ChenFU-CN13/esp32-stm32-ab-ota/DOC/images/hardware/项目实物图2.jpg

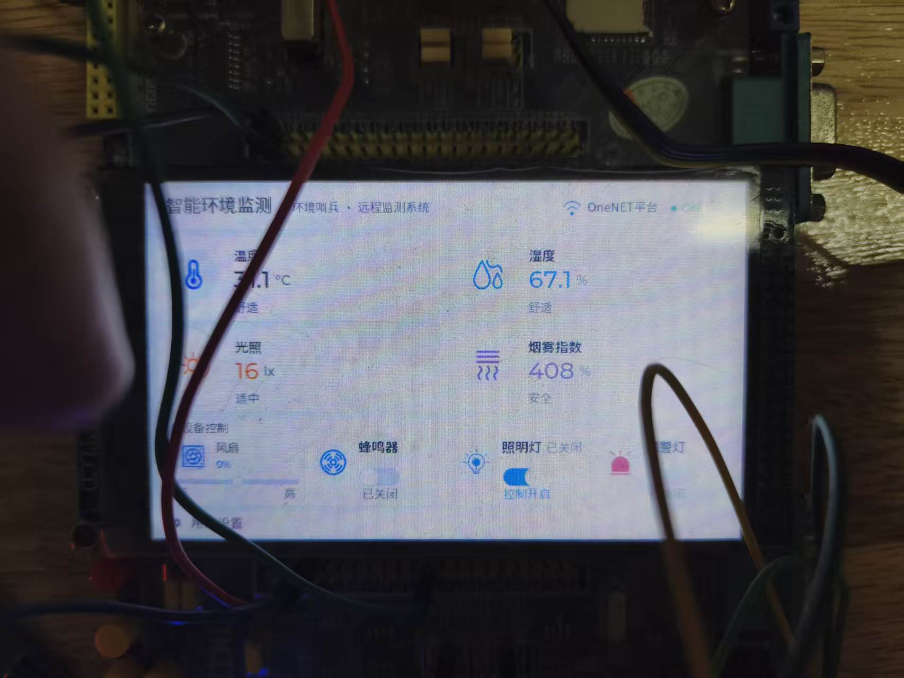
DOC/images/hardware/项目实物图2.jpg
