ChenFU-CN13/esp32-stm32-ab-ota/DOC/images/hardware/BH1750反面.png

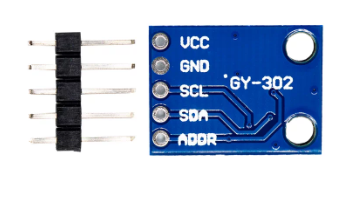
DOC/images/hardware/BH1750反面.png
