ChenFU-CN13/esp32-stm32-ab-ota/ESP32S3-OTA/readme.txt

注意:每次复制上一个项目进行修改时，cmake不会自动更改相对应的绝对路径，所以
每次都需要先在端口中输入idf.py fullclean 清理缓存，然后重新buil一下，这样文件才不会爆红

本次test10
加入了串口固件传输协议
/*============================================================================
 *                      串口固件传输协议定义
 *============================================================================
 * 协议帧格式说明：
 * 
 * 1. 固件信息帧（命令0x05）：
 *    | 包头(1) | 命令(1) | 固件大小(4) | 分隔符(2) | 版本号(4) | CRC32(4) | 包尾(1) |
 *    总长度：17字节
 * 
 * 2. 固件数据帧（命令0x06）：
 *    | 包头(1) | 命令(1) | 包序号(2) | 数据长度(4) | 数据(1024) | CRC32(4) | 包尾(1) |
 *    总长度：1037字节
 * 
 * 3. 简单命令帧（通知/确认/结束）：
 *    | 包头(1) | 命令(1) | 包尾(1) |
 *    总长度：3字节
 * 
 * 传输流程：
 *    ESP32 -> STM32: 升级通知(0x01)
 *    STM32 -> ESP32: ACK应答(0x02)
 *    ESP32 -> STM32: 确认(0x03)
 *    STM32 -> ESP32: ACK应答(0x02)
 *    ESP32 -> STM32: 开始传输(0x04)      <-- ESP32主动通知开始传输
 *    STM32 -> ESP32: ACK应答(0x02)       //此时STM32应先完成檫除，再应答
 *    ESP32 -> STM32: 固件信息(0x05)
 *    STM32 -> ESP32: ACK应答(0x02)
 *    ESP32 -> STM32: 数据包0~N(0x06)
 *    STM32 -> ESP32: ACK应答(0x02) [每包都应答]
 *    ESP32 -> STM32: 升级结束(0x07)
 *    STM32 -> ESP32: ACK应答(0x02) [然后重启]
 *============================================================================*/
