ChenFU-CN13/esp32-stm32-ab-ota/STM32-OTA/readme.txt

当前初步OTA升级已经完成了

不过一些流程还是要手动实施一步分才行

流程：1.STM32端要先把B区下载，然后再把测试A区下载
然后上传APP固件到onenet平台，先下发验证升级

2.此时EPS32开始下载固件到spiffs文件系统中

3.接着STM32与ESP32保持正常串口通讯即可

后续优化：
1.ESP32要可以持续监听onenet平台下发固件版本升级通知
并且不能影响物模型数据上传到onenet平台

2.ESP32传输完成固件后，就需要最新的版本号上报给onenet平台

3.STM32更新完成后会直接跳转到A区
首先在程序开始时，要把存储在AT24C02的版本号发送给
ESP32,ESP32要接收到并上报给onenet平台

4.在A区运行时，要添加监听ESP32是否传过来固件升级通知
如果有就要及时跳转回B区，也就是重启

5.双端加入NACK机制
STM32如果接收数据帧，信息帧等 数据包出现 大小不一致，内容不一致
就返回NACK,如果ESP32就暂停发送数据包

6.STM32利用W25Q128实现3分区，在收到2次握手后，
先把当前A分区的固件，存储到W25Q128中，然后再进行协议传输
因为A区固件是一边接收一边写入，所以当出现任意一帧数据解析有问题
就返回NACK给ESP32停止发送数据包
并且进行固件版本回滚

注意：版本号，固件大小也要回滚，也要在收到2次握手后
在AT24C02中开辟新空间，把旧的的固件信息写入到里面

回滚时读取出来

7.STM32app程序开始时，要想办法，可以在LVGL上可以显示当前版本号
（点击设置按钮后，可以看到版本信息，后续改为不是收到升级通知帧就马上
重启到B区，而是自主选择重启时机，因此ESP32那边也要想办法适配）
