ChenFU-CN13/esp32-stm32-ab-ota/DOC/development-notes/STM32_A区APP开发与实机验证记录.md

# STM32 A区 APP 开发与实机验证记录

> 本文件只记录 STM32 A区业务 APP 的开发完成度、实机验证、遗留问题和下一步建议；整个双端工程与 OTA 总进度以根目录 `README.md` 为准。

记录日期：2026-10-17
当前阶段：S1~S5与SHT30 Modbus替换已进入正式业务链，正式版v2.0.0 OTA回归通过；进入发布材料与Git稳定基线整理
正式目标：STM32-OTA/A区智能哨兵环境监测系统
APP 版本：v2.0.0

一、本轮已完成
--------------

1. STM32 驱动层
   - 新增 fan_pwm.c/h：PE5/TIM9_CH1、PE6/TIM9_CH2，两路同步 PWM，默认 0%。
   - 当前计数频率 10 kHz、周期计数 100，因此实际 PWM 频率为 100 Hz；80% 占空比已实机带动当前 5V 两线风扇。
   - 新增 mq2.c/h：PA1/ADC1_IN1，12 位 ADC；任务每 500 ms 采集一次，每次取 5 点中位数。
   - 新增 bh1750.c/h：PB6(SCL)/PB7(SDA) 软件 I2C，ADDR 接地地址 0x23，连续高分辨率模式；按 raw×5/6 换算 lux。
   - 新增 modbus_th.c/h：USART3（PB10/PB11）连接外接自动方向TTL-RS485模块，按Modbus RTU读取SHT30定点温湿度。
   - USART3使用9600、8N1，从机地址1；不使用板载RS485电路，不配置DE/RE引脚。
   - PB10/PB11不再给BH1750使用，已经作为正式SHT30采集链路启用。

2. 配置管理
   - 新增 config_manager.c/h，app_config_t 固定 16 字节，地址 0x70~0x7F。
   - 当前默认值：温度 28.0℃、湿度 80%、烟雾 ADC 1500、光照 5/20 lx。
   - 已加入一次性兼容迁移：EEPROM 中若仍是旧光照默认值 50/200 lx，则迁移为 5/20 lx，其他用户配置保持不变。
   - 加减按钮只更新 RAM；点击“保存设置”后统一写 EEPROM，再读回比对；magic 无效时恢复默认值并保存。

3. 报警与执行器仲裁
   - 新增 alarm_engine.c/h、fan_controller.c/h；AlarmEngineTask 每 200 ms 运行一次，连续 10 次成立或解除后才切换，约 2 秒去抖。
   - 所有阈值均采用严格大于号：当前值等于阈值时不报警，超过阈值约 2 秒才报警。
   - 烟雾为最高优先级：红灯快闪、蜂鸣器断续响、双风扇 100%。
   - 温度或湿度任一超限：双风扇固定 80%，不强制声光报警；当前仍是分段控制，不是 PI/PID。
   - 风扇 PWM 只有 AlarmEngineTask 一个最终写入点，LVGL 风扇条只显示最终占空比。
   - 自动照明控制默认开启。LVGL 开关表示“自动控制是否允许”，另行显示照明灯当前实际状态，避免把“自动控制开启”误解为“灯已点亮”。

4. FreeRTOS 与 LVGL UI
   - 已接入 SHT30Task、SmokeTask、LightTask、AlarmEngineTask；旧DHT11Task已退出正式业务链。
   - 首页周期显示温度、湿度、烟雾 ADC、光照 lux、风扇占空比和 IOT ON/NC 状态，并加入 USART1 数据日志。
   - STM32内部温湿度使用`temp_x10/humi_x10`定点数，LVGL显示1位小数；数据无效时显示`NC`。
   - 设置页已接入温度、湿度、光照上限和烟雾阈值；“保存设置”“恢复默认”已接入配置管理。
   - 正式版本为v2.0.0；升级后AT24C02版本字段、STM32上报和ESP32确认结果一致。

5. STM32 与 ESP32-S3
   - STM32 新增 0x06 烟雾、0x07 光照、0x08 双风扇最终占空比上报。
   - ESP32-S3 已增加对应帧的校验、队列解析和 OneNET 属性上报。
   - 新增 0x0A 心跳：ESP32 每 5 秒发送 OneNET 在线状态；STM32 超过 15 秒未收到则显示 NC；心跳不回 ACK。
   - OneNET 当前使用 Alarm、Fan、LED、Lux、Smoke、hum、temp 共 7 个属性；IOT 心跳只用于本地显示。
   - 温湿度0x01/0x02业务帧格式保持不变；STM32发送前将x10定点数四舍五入成整数，因此ESP32和OneNET本轮不需要修改。

二、已完成的静态检查
--------------------

1. Keil uvprojx XML 可解析，新增驱动、服务、HAL ADC和modbus_th.c文件已注册。
2. 已检查 0x06/0x07/0x08/0x0A 协议、OneNET 属性大小写、配置单次写入、风扇单点输出和照明状态显示路径。
3. 正式APP已取消NO_BOOT_MODE，链接地址恢复为`0x08010000`；Bootloader链接范围限制为64KB，ESP32 OTA Manager已重新启用。
4. 本次文档同步没有由Codex重新运行Keil或ESP-IDF编译；下面的硬件结果来自BOSS已完成的编译、烧录、串口日志、截图和仪器测量。

三、已完成的实机验证
--------------------

1. 共地问题已解决
   - 初次接线时 STM32、外部电源、传感器和风扇驱动没有统一信号地，出现 BH1750 初始化成功但长期读 0 等现象。
   - 正确接法：STM32 GND、外部电源 GND、各传感器 GND、风扇驱动 GND 必须共地；模块 VCC 可由外部电源供电。
   - 不要直接并联两个不同来源的 VCC 电源轨，共地只用于建立统一信号参考。

2. 光照链路
   - BH1750 初始化成功；遮住感光窗口后读数可接近 0，说明当前基本 I2C 通讯和感光响应正常。
   - 房间实测“开灯约 32 lx、关灯约 0~3 lx”，因此光照默认滞回从 50/200 lx 调整为 5/20 lx。
   - 自动照明默认开启及“控制状态/实际灯状态”分离已完成。

3. 温湿度阈值与风扇报警链路
   - 湿度阈值设为 60% 时，读数等于 60% 不触发；读数为 61% 并持续约 2 秒后打印 `[ALARM] level 0 -> 1, fan=80%`。
   - 湿度回到 60% 并持续约 2 秒后打印 `[ALARM] level 1 -> 0, fan=0%`。
   - 该结果确认严格 `>` 比较、2 秒去抖、报警等级切换和 0/80% PWM 命令链路均已运行。

4. 风扇 PWM 硬件链路
   - PE5 栅极测得约 80% 占空比，栅极与 MCU 输出一致；低边 MOS 漏极波形呈互补关系，说明 TIM9、GPIO 复用和 MOS 开关路径正常。
   - 风扇 IN 直接接 3.3V 时可以全速启动，说明风扇、电源和驱动板主回路可工作。
   - 原 10 kHz PWM 下只有电流声、风扇不转；改为 100 Hz 后，80% 占空比可以正常起转。该结论仅针对当前这款两线 5V 风扇和驱动板，不外推到所有风扇。

5. MQ-2 预热
   - 上电早期 ADC 长时间保持 4095，约 15 分 46 秒后降到约 370 并逐渐稳定，证明必须设置预热屏蔽期。
   - 当前源码预热时间为 1200000 ms（20 分钟）；预热期间允许采样和显示，但烟雾数据不参与报警。

6. SHT30 Modbus温湿度链路
   - F103来源驱动的16位定点读取和32位浮点读取此前已经完成编译、烧录和逻辑分析仪验证。
   - F407冒烟阶段可见请求`01 04 00 00 00 02 71 CB`及合法响应；示例响应解析为30.8℃、64.6%RH，CRC正确。
   - BOSS于2026-10-17确认正式业务代码能够正常通讯，LVGL能够正常显示1位小数。
   - 本次只把正常通讯和正常显示标记为实机通过；ESP32/OneNET整数上报及RS485故障退化仍需最终回归。

7. 正式版v2.0.0 OTA回归
   - BOSS于2026-10-17完成正式双端OTA升级回归。
   - 新APP启动后从AT24C02读取`2.0.0`并上报；ESP32日志确认`STM32 APP version=2.0.0`，Manager进入`REPORT_RESULT`。
   - 现场截图确认STM32侧收到ESP32版本ACK，并打印“ESP32已确认当前APP版本 2.0.0”。本记录不补写截图未提供的包数和CRC32。

四、踩过的坑与当前遗留问题
--------------------------

1. 风扇 PWM 频率不能只按通用经验决定
   - 现象：10 kHz、80% 时只听到嘶嘶声，风扇不转。
   - 排查：PE5、MOS 栅极、漏极波形正常，IN 直给 3.3V 能全速转。
   - 结论：当前两线无刷风扇内部驱动与 10 kHz 斩波不匹配，100 Hz 实机可用。以后更换风扇后要重新测启动占空比和适用频率。

2. 风扇动作会干扰 MQ-2 ADC，尚未修复
   - 现象：风扇 100 Hz、80% 工作时，MQ-2 偶发从约 280~550 突跳到 4095；调高温湿度阈值让风扇停止后，4095 突跳消失。
   - 当前判断：这条因果关系已经由对照实验确认；具体耦合路径仍未确认，优先怀疑电源压降、地弹噪声、MOS 开关干扰或 ADC 输入瞬时过压。
   - 当前 5 点中位数是一次连续快速采样，如果干扰持续覆盖这 5 点，仍会得到 4095，不能替代硬件排查。
   - 后续检查：分别测 5V、3.3V、VDDA、PA1/AO 和地线压差；风扇电源支路加近端电容并优化星形接地；必要时给 AO 加 RC 滤波和限压/分压。
   - 风扇模块若由 5V 供电，MQ-2 AO 是否可能超过 STM32 ADC 允许范围尚未完成实测和数据手册核对，不能直接下结论。

3. BH1750 基本通讯正常，但长期数值变化原因未定
   - 遮住窗口可接近 0，说明不能再简单归因于“I2C 不通”。
   - 房间灯光不变时，数值曾从约 33 lx 上升到 166~177 lx；还需做“风扇停/转”对照、固定传感器位置、排除屏幕和环境反射，并测模块供电与地线噪声。

4. DHT11间歇失败已通过替换采集源退出当前业务链
   - 原DHT11的`read FAIL/recovered`证据继续保留，说明更换工业通信传感器的原因。
   - 正式温湿度来源已经改为USART3外接SHT30 Modbus模块；DHT11驱动源文件暂时保留作回退材料，但任务和业务有效标志已经移除。

5. MQ-2 日志文字与实际预热常量不一致
   - 当前实际常量为 20 分钟，但启动日志仍可能打印 180 s，源码注释也曾写成约 16 分钟。
   - 本轮按“先记录、不处理小 BUG”的决定保留，后续修复时只同步文字，不改变已经验证的预热策略。

五、下一步控制升级：先做 PI，不直接上完整 PID
------------------------------------------

1. 控制对象定义
   - 当前两线风扇没有转速反馈，无法做真正的风扇转速闭环。
   - 下一步 PI 控制的是“温度/湿度偏差 → 风扇 PWM 占空比”，属于环境量慢闭环；烟雾报警仍保留 100% 最高优先级覆盖。

2. 传感器升级状态
   - PB10/PB11对应USART3的SHT30 Modbus采集已经完成正式接入，STM32内部和LVGL保留0.1精度。
   - 当前驱动已有CRC和超时返回，失败时UI显示`NC`，报警引擎不再使用旧温湿度；自动重试采用下一个1秒采集周期重新读取。
   - 完成断电、A/B接反、ESP32/OneNET上报和恢复回归后，再接PI，避免控制算法建立在未经故障验证的输入上。

3. PI 第一版建议
   - PWM 载波继续使用已验证的 100 Hz；PI 计算周期按温湿度传感器速度设置为 2~5 秒，不需要跟着 PWM 周期计算。
   - 温度误差和湿度误差分别计算需求占空比，最终取较大值；输出限幅 0~100%。
   - 加入最小可运行占空比、启动时短暂 100% 助推、积分限幅/抗饱和，防止低占空比只响不转和积分越积越大。
   - 传感器无效或 RS485 超时进入安全退化；烟雾报警直接强制 100%，不经过 PI。
   - 调参顺序：先令 Ki=0 调 Kp，再逐步增加 Ki 消除稳态误差；当前阶段不加 D，避免放大现场通讯和环境噪声。

六、暂缓项
----------

1. 仍需修复：风扇引起的 MQ-2 4095、BH1750 长期漂移和 MQ-2 预热日志文字不一致。DHT11间歇失败已通过SHT30替换退出正式业务链。
2. 暂不实现：PI、手动风扇输入、OneNET 0x8X 阈值下发、报警复位/冷却、历史记录、ESP32 自升级。
3. AT24C02 `0x2C`版本字段已随正式OTA更新为v2.0.0，并完成STM32读取、ESP32确认闭环。
4. 正式发布配置不再使用NO_BOOT_MODE；如以后临时恢复直刷调试，必须重新检查链接地址和版本元数据边界。

七、最终项目打磨顺序
--------------------

1. 先完成Keil全量编译和基础回归：SHT30小数显示、温湿度80%风扇、烟雾100%覆盖、光照灯、IOT心跳和配置保存。
2. 用逻辑分析仪抓USART2的0x01/0x02帧，确认30.8/64.6按31/65发送，并核对ESP32 ACK及OneNET hum/temp刷新。
3. 分别测试TTL-RS485模块断电、A/B接反、传感器无响应和恢复，确认UI显示`NC`、约2秒后退出温湿度风扇且其他任务不受影响。
4. 完成风扇停/转时5V、3.3V、VDDA、PA1和地线压差的对照测量，确认MQ-2 AO峰值及ADC输入保护方案。
5. 固定BH1750位置和光源，记录风扇停/转两组长期数据，判断变化是否跟供电干扰同步。
6. 修正MQ-2预热日志文字，清理APP_Tasks.c中的旧DHT11说明注释和SHT30“每2秒”过期注释，再清理冒烟日志及备份/编译产物。
7. 正式v2.0.0 OTA升级已通过；现在统一记录、隔离凭据和生成物并建立Git稳定提交。破坏性回滚不在本轮重复执行。
