ChenFU-CN13/esp32-stm32-ab-ota/STM32-OTA/doc/LVGL首页界面.png

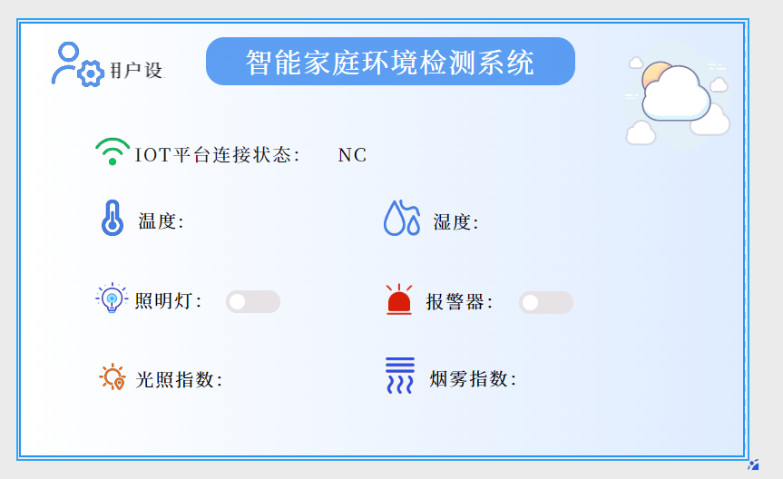
STM32-OTA/doc/LVGL首页界面.png
