ChenFU-CN13/esp32-stm32-ab-ota/DOC/verification/README.md

# 实机验证记录与证据边界

本页把结论分成三类：有完整日志或明确故障注入的“已验证”、由用户实机确认但材料不完整的“用户确认”、尚未执行的“待验证”。这样可以避免把代码已实现写成实机已通过。

## 2026-10-31 更新

新增 [串口组帧与 Python OTA 测试验证](2026-10-31-uart-python-ota.md)：

- 8+1029 字节两段拆分、七段拆分和相邻两帧粘连均完成实机验证，最终镜像 CRC 与版本确认通过。
- 整体 CRC 拒收、主动 ABORT、数据超时三类恢复后，均直接完成新的正常升级；备份与恢复 CRC 一致。
- 确认 212/424 包后实际拔整板 USB，重新上电恢复旧 APP 2.0.7；本次只覆盖这一断电阶段。
- ESP32-S3 正常 OTA 完成 2.0.7 → 2.0.8，433356 字节、整体 CRC `BE9E415E`，目标版本及 OneNET step 201 确认通过，后续 MQTT 通信继续。
- 公开材料为 [结果摘要](2026-10-31/results.json) 和 [关键日志摘录](2026-10-31/stm32-excerpts.txt)。最终 ESP32 一轮依据作者实机确认与关键截图，未公开完整双端日志。

运行步骤见 [Python 测试说明](../../Python_test/README.md)。当前 APP 标识为 2.0.8，以下表格保留已有历史验证，不表示本次全部重新执行。

## 已验证

| 用例 | 结果 | 关键观察 |
|---|---|---|
| R0：旧基线迁移 | 通过 | 旧 APP 镜像 CRC、向量表与跳转日志均正常。 |
| R1：正常升级 | 通过 | 先备份旧 APP，再擦除/写入；整包 CRC 一致并跳转新 APP。 |
| R2：整体 CRC 失败 | 通过 | STM32 返回 `NACK 0x05`，ESP32 ABORT，Bootloader 恢复旧镜像。 |
| R3：传输中 ABORT | 通过 | STM32 ACK 后进入回滚，旧 APP 可重新启动。 |
| R4：升级中断电 | 通过 | 擦除阶段和数据阶段断电后，重启均可识别 `UPGRADING` 并恢复旧镜像。 |
| W0：正常启动接管 IWDG | 通过 | Bootloader 启动 IWDG，APP 接管后没有误复位。 |
| W1：完整 OTA 期间 IWDG | 通过 | 备份、擦除、传输、CRC 和跳转期间没有误触发看门狗。 |
| W2：停止喂狗故障注入 | 通过 | A 区擦除后停止喂狗，IWDG 复位，Bootloader 随后完成回滚。 |
| V4：ESP32 单独重启后的版本回查 | 通过 | ESP32 发送 `66 09 BB`，运行中的 STM32 APP 重新上报当前版本。 |

## 用户实机确认

| 项目 | 已确认内容 | 边界 |
|---|---|---|
| SHT30 Modbus | 合法请求/响应、解析成功、LVGL 显示一位小数。 | 没有保存断线、A/B 接反和恢复全过程日志。 |
| 正式版 v2.0.0 OTA 回归 | 新 APP 启动、读取 AT24C02 版本、ESP32 确认版本并进入结果上报。 | 没有保存完整双端原始日志，不补写未提供的包数和 CRC。 |

## 后续验证与已知边界

- ESP32 异常回滚后的整次自动重试、跨轮任务缓存复用尚未完成专项闭环。
- 简单命令/信息帧拆分、其他分段间隔、重复帧粘连和容量边界尚未全部覆盖。
- 主动破坏 W25Q128 备份镜像，确认校验失败后停留在 Bootloader，而不是跳转损坏 APP。
- RS485 模块断电、A/B 接反、传感器无响应和恢复场景。
- 抓取 `30.8 / 64.6` 对应的 STM32→ESP32 整数业务帧和 ACK，确认 OneNET 属性持续刷新。
- 测量风扇启停时的 5 V、电源地和 MQ-2 AO，定位 ADC 偶发满量程问题。
- 固定光源下持续观察 BH1750，区分供电、环境和传感器自身因素。

## OneNET 材料

OneNET 原始截图已完成本地归档，但画面包含平台账号编号、Product ID、设备名和批次 ID。本轮不把原图加入公开目录；后续裁掉这些标识后，再补充设备在线、属性上报、多轮 OTA 和升级成功截图。

## 证据口径

2026-10-31 新测试由项目作者在开发板上执行，当前更新读取采集记录并核对截图。发布前执行 23 个 Python 离线测试方法，未在发布操作中重新编译、烧录或连接真实串口。历史记录、实机新测试和离线模拟分别陈述。
