ChenFU-CN13/esp32-stm32-ab-ota/STM32-OTA/testB3_backe/MDK-ARM/test1/test1.htm

# Static Call Graph for image test1\test1.axf

#<CALLGRAPH># ARM Linker, 5060960: Last Updated: Mon Mar 23 01:16:48 2026

### Maximum Stack Usage = 2248 bytes + Unknown(Cycles, Untraceable Function Pointers)

### Call chain for Maximum Stack Depth:

main ⇒ Task_While ⇒ OTA_RunUpgradeProcess ⇒ OTA_ProcessFrame ⇒ OTA_WriteFirmwareData ⇒ MyFlash_WriteBuffer ⇒ MyFlash_WriteWord ⇒ HAL_FLASH_Program ⇒ FLASH_WaitForLastOperation

### Mutually Recursive functions

- ADC_IRQHandler ⇒ ADC_IRQHandler
- BusFault_Handler ⇒ BusFault_Handler
- HardFault_Handler ⇒ HardFault_Handler
- MemManage_Handler ⇒ MemManage_Handler
- NMI_Handler ⇒ NMI_Handler
- UART_EndRxTransfer ⇒ UART_EndRxTransfer
- UsageFault_Handler ⇒ UsageFault_Handler
- UART_EndTxTransfer ⇒ UART_EndTxTransfer

### Function Pointers

- ADC_IRQHandler from startup_stm32f407xx.o(.text) referenced from startup_stm32f407xx.o(RESET)
- BusFault_Handler from stm32f4xx_it.o(i.BusFault_Handler) referenced from startup_stm32f407xx.o(RESET)
- CAN1_RX0_IRQHandler from startup_stm32f407xx.o(.text) referenced from startup_stm32f407xx.o(RESET)
- CAN1_RX1_IRQHandler from startup_stm32f407xx.o(.text) referenced from startup_stm32f407xx.o(RESET)
- CAN1_SCE_IRQHandler from startup_stm32f407xx.o(.text) referenced from startup_stm32f407xx.o(RESET)
- CAN1_TX_IRQHandler from startup_stm32f407xx.o(.text) referenced from startup_stm32f407xx.o(RESET)
- CAN2_RX0_IRQHandler from startup_stm32f407xx.o(.text) referenced from startup_stm32f407xx.o(RESET)
- CAN2_RX1_IRQHandler from startup_stm32f407xx.o(.text) referenced from startup_stm32f407xx.o(RESET)
- CAN2_SCE_IRQHandler from startup_stm32f407xx.o(.text) referenced from startup_stm32f407xx.o(RESET)
- CAN2_TX_IRQHandler from startup_stm32f407xx.o(.text) referenced from startup_stm32f407xx.o(RESET)
- DCMI_IRQHandler from startup_stm32f407xx.o(.text) referenced from startup_stm32f407xx.o(RESET)
- DMA1_Stream0_IRQHandler from startup_stm32f407xx.o(.text) referenced from startup_stm32f407xx.o(RESET)
- DMA1_Stream1_IRQHandler from startup_stm32f407xx.o(.text) referenced from startup_stm32f407xx.o(RESET)
- DMA1_Stream2_IRQHandler from startup_stm32f407xx.o(.text) referenced from startup_stm32f407xx.o(RESET)
- DMA1_Stream3_IRQHandler from startup_stm32f407xx.o(.text) referenced from startup_stm32f407xx.o(RESET)
- DMA1_Stream4_IRQHandler from startup_stm32f407xx.o(.text) referenced from startup_stm32f407xx.o(RESET)
- DMA1_Stream5_IRQHandler from stm32f4xx_it.o(i.DMA1_Stream5_IRQHandler) referenced from startup_stm32f407xx.o(RESET)
- DMA1_Stream6_IRQHandler from stm32f4xx_it.o(i.DMA1_Stream6_IRQHandler) referenced from startup_stm32f407xx.o(RESET)
- DMA1_Stream7_IRQHandler from startup_stm32f407xx.o(.text) referenced from startup_stm32f407xx.o(RESET)
- DMA2_Stream0_IRQHandler from startup_stm32f407xx.o(.text) referenced from startup_stm32f407xx.o(RESET)
- DMA2_Stream1_IRQHandler from startup_stm32f407xx.o(.text) referenced from startup_stm32f407xx.o(RESET)
- DMA2_Stream2_IRQHandler from stm32f4xx_it.o(i.DMA2_Stream2_IRQHandler) referenced from startup_stm32f407xx.o(RESET)
- DMA2_Stream3_IRQHandler from startup_stm32f407xx.o(.text) referenced from startup_stm32f407xx.o(RESET)
- DMA2_Stream4_IRQHandler from startup_stm32f407xx.o(.text) referenced from startup_stm32f407xx.o(RESET)
- DMA2_Stream5_IRQHandler from startup_stm32f407xx.o(.text) referenced from startup_stm32f407xx.o(RESET)
- DMA2_Stream6_IRQHandler from startup_stm32f407xx.o(.text) referenced from startup_stm32f407xx.o(RESET)
- DMA2_Stream7_IRQHandler from startup_stm32f407xx.o(.text) referenced from startup_stm32f407xx.o(RESET)
- DebugMon_Handler from stm32f4xx_it.o(i.DebugMon_Handler) referenced from startup_stm32f407xx.o(RESET)
- ETH_IRQHandler from startup_stm32f407xx.o(.text) referenced from startup_stm32f407xx.o(RESET)
- ETH_WKUP_IRQHandler from startup_stm32f407xx.o(.text) referenced from startup_stm32f407xx.o(RESET)
- EXTI0_IRQHandler from startup_stm32f407xx.o(.text) referenced from startup_stm32f407xx.o(RESET)
- EXTI15_10_IRQHandler from startup_stm32f407xx.o(.text) referenced from startup_stm32f407xx.o(RESET)
- EXTI1_IRQHandler from startup_stm32f407xx.o(.text) referenced from startup_stm32f407xx.o(RESET)
- EXTI2_IRQHandler from startup_stm32f407xx.o(.text) referenced from startup_stm32f407xx.o(RESET)
- EXTI3_IRQHandler from startup_stm32f407xx.o(.text) referenced from startup_stm32f407xx.o(RESET)
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
- TIM4_IRQHandler from startup_stm32f407xx.o(.text) referenced from startup_stm32f407xx.o(RESET)
- TIM5_IRQHandler from startup_stm32f407xx.o(.text) referenced from startup_stm32f407xx.o(RESET)
- TIM6_DAC_IRQHandler from startup_stm32f407xx.o(.text) referenced from startup_stm32f407xx.o(RESET)
- TIM7_IRQHandler from startup_stm32f407xx.o(.text) referenced from startup_stm32f407xx.o(RESET)
- TIM8_BRK_TIM12_IRQHandler from startup_stm32f407xx.o(.text) referenced from startup_stm32f407xx.o(RESET)
- TIM8_CC_IRQHandler from startup_stm32f407xx.o(.text) referenced from startup_stm32f407xx.o(RESET)
- TIM8_TRG_COM_TIM14_IRQHandler from startup_stm32f407xx.o(.text) referenced from startup_stm32f407xx.o(RESET)
- TIM8_UP_TIM13_IRQHandler from startup_stm32f407xx.o(.text) referenced from startup_stm32f407xx.o(RESET)
- UART4_IRQHandler from startup_stm32f407xx.o(.text) referenced from startup_stm32f407xx.o(RESET)
- UART5_IRQHandler from startup_stm32f407xx.o(.text) referenced from startup_stm32f407xx.o(RESET)
- UART_DMAAbortOnError from stm32f4xx_hal_uart.o(i.UART_DMAAbortOnError) referenced from stm32f4xx_hal_uart.o(i.HAL_UART_IRQHandler)
- UART_DMAError from stm32f4xx_hal_uart.o(i.UART_DMAError) referenced from stm32f4xx_hal_uart.o(i.UART_Start_Receive_DMA)
- UART_DMAReceiveCplt from stm32f4xx_hal_uart.o(i.UART_DMAReceiveCplt) referenced from stm32f4xx_hal_uart.o(i.UART_Start_Receive_DMA)
- UART_DMARxHalfCplt from stm32f4xx_hal_uart.o(i.UART_DMARxHalfCplt) referenced from stm32f4xx_hal_uart.o(i.UART_Start_Receive_DMA)
- USART1_IRQHandler from stm32f4xx_it.o(i.USART1_IRQHandler) referenced from startup_stm32f407xx.o(RESET)
- USART2_IRQHandler from stm32f4xx_it.o(i.USART2_IRQHandler) referenced from startup_stm32f407xx.o(RESET)
- USART3_IRQHandler from startup_stm32f407xx.o(.text) referenced from startup_stm32f407xx.o(RESET)
- USART6_IRQHandler from startup_stm32f407xx.o(.text) referenced from startup_stm32f407xx.o(RESET)
- UsageFault_Handler from stm32f4xx_it.o(i.UsageFault_Handler) referenced from startup_stm32f407xx.o(RESET)
- WWDG_IRQHandler from startup_stm32f407xx.o(.text) referenced from startup_stm32f407xx.o(RESET)
- __main from entry.o(.ARM.Collect$$$$00000000) referenced from startup_stm32f407xx.o(.text)
- _snputc from printfa.o(i._snputc) referenced from printfa.o(i.__0vsnprintf)
- main from main.o(i.main) referenced from entry9a.o(.ARM.Collect$$$$0000000B)

### Global Symbols

__main (Thumb, 0 bytes, Stack size unknown bytes, entry.o(.ARM.Collect$$$$00000000))
[Address Reference Count : 1]

- startup_stm32f407xx.o(.text)

_main_stk (Thumb, 0 bytes, Stack size unknown bytes, entry2.o(.ARM.Collect$$$$00000001))

_main_scatterload (Thumb, 0 bytes, Stack size unknown bytes, entry5.o(.ARM.Collect$$$$00000004))

[Calls]

- >> __scatterload

__main_after_scatterload (Thumb, 0 bytes, Stack size unknown bytes, entry5.o(.ARM.Collect$$$$00000004))

[Called By]

- >> __scatterload

_main_clock (Thumb, 0 bytes, Stack size unknown bytes, entry7b.o(.ARM.Collect$$$$00000008))

_main_cpp_init (Thumb, 0 bytes, Stack size unknown bytes, entry8b.o(.ARM.Collect$$$$0000000A))

_main_init (Thumb, 0 bytes, Stack size unknown bytes, entry9a.o(.ARM.Collect$$$$0000000B))

__rt_lib_shutdown_fini (Thumb, 0 bytes, Stack size unknown bytes, entry12b.o(.ARM.Collect$$$$0000000E))

__rt_final_cpp (Thumb, 0 bytes, Stack size unknown bytes, entry10a.o(.ARM.Collect$$$$0000000F))

__rt_final_exit (Thumb, 0 bytes, Stack size unknown bytes, entry11a.o(.ARM.Collect$$$$00000011))

MSR_SP (Thumb, 6 bytes, Stack size 0 bytes, tasktest.o(.emb_text))

[Called By]

- >> Load_A

Reset_Handler (Thumb, 8 bytes, Stack size 0 bytes, startup_stm32f407xx.o(.text))
[Address Reference Count : 1]

- startup_stm32f407xx.o(RESET)

ADC_IRQHandler (Thumb, 0 bytes, Stack size 0 bytes, startup_stm32f407xx.o(.text))

[Calls]

- >> ADC_IRQHandler

[Called By]

- >> ADC_IRQHandler

[Address Reference Count : 1]

- startup_stm32f407xx.o(RESET)

CAN1_RX0_IRQHandler (Thumb, 0 bytes, Stack size 0 bytes, startup_stm32f407xx.o(.text))
[Address Reference Count : 1]

- startup_stm32f407xx.o(RESET)

CAN1_RX1_IRQHandler (Thumb, 0 bytes, Stack size 0 bytes, startup_stm32f407xx.o(.text))
[Address Reference Count : 1]

- startup_stm32f407xx.o(RESET)

CAN1_SCE_IRQHandler (Thumb, 0 bytes, Stack size 0 bytes, startup_stm32f407xx.o(.text))
[Address Reference Count : 1]

- startup_stm32f407xx.o(RESET)

CAN1_TX_IRQHandler (Thumb, 0 bytes, Stack size 0 bytes, startup_stm32f407xx.o(.text))
[Address Reference Count : 1]

- startup_stm32f407xx.o(RESET)

CAN2_RX0_IRQHandler (Thumb, 0 bytes, Stack size 0 bytes, startup_stm32f407xx.o(.text))
[Address Reference Count : 1]

- startup_stm32f407xx.o(RESET)

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

USART3_IRQHandler (Thumb, 0 bytes, Stack size 0 bytes, startup_stm32f407xx.o(.text))
[Address Reference Count : 1]

- startup_stm32f407xx.o(RESET)

USART6_IRQHandler (Thumb, 0 bytes, Stack size 0 bytes, startup_stm32f407xx.o(.text))
[Address Reference Count : 1]

- startup_stm32f407xx.o(RESET)

WWDG_IRQHandler (Thumb, 0 bytes, Stack size 0 bytes, startup_stm32f407xx.o(.text))
[Address Reference Count : 1]

- startup_stm32f407xx.o(RESET)

__aeabi_uldivmod (Thumb, 98 bytes, Stack size 40 bytes, uldiv.o(.text))

[Stack]

- Max Depth = 40
- Call Chain = __aeabi_uldivmod

[Calls]

- >> __aeabi_llsr
- >> __aeabi_llsl

[Called By]

- >> HAL_RCC_GetSysClockFreq
- >> _printf_core
- >> _fp_digits
- >> UART_SetConfig

__aeabi_memcpy (Thumb, 36 bytes, Stack size 0 bytes, memcpya.o(.text))

[Called By]

- >> OTA_WriteFirmwareData
- >> OTA_ParseDataFrame

__aeabi_memcpy4 (Thumb, 0 bytes, Stack size 0 bytes, memcpya.o(.text), UNUSED)

__aeabi_memcpy8 (Thumb, 0 bytes, Stack size 0 bytes, memcpya.o(.text), UNUSED)

__aeabi_memset (Thumb, 14 bytes, Stack size 0 bytes, memseta.o(.text))

[Called By]

- >> _memset$wrapper
- >> __aeabi_memclr
- >> OTA_WriteFirmwareData

__aeabi_memset4 (Thumb, 0 bytes, Stack size 0 bytes, memseta.o(.text), UNUSED)

__aeabi_memset8 (Thumb, 0 bytes, Stack size 0 bytes, memseta.o(.text), UNUSED)

__aeabi_memclr (Thumb, 4 bytes, Stack size 0 bytes, memseta.o(.text), UNUSED)

[Calls]

- >> __aeabi_memset

__aeabi_memclr4 (Thumb, 0 bytes, Stack size 0 bytes, memseta.o(.text))

[Called By]

- >> HAL_UART_MspInit
- >> HAL_SPI_MspInit
- >> HAL_I2C_MspInit
- >> MX_GPIO_Init
- >> SystemClock_Config

__aeabi_memclr8 (Thumb, 0 bytes, Stack size 0 bytes, memseta.o(.text), UNUSED)

_memset$wrapper (Thumb, 18 bytes, Stack size 8 bytes, memseta.o(.text), UNUSED)

[Calls]

- >> __aeabi_memset

__aeabi_uidiv (Thumb, 0 bytes, Stack size 12 bytes, uidiv.o(.text), UNUSED)

__aeabi_uidivmod (Thumb, 44 bytes, Stack size 12 bytes, uidiv.o(.text), UNUSED)

[Called By]

- >> _printf_core

__aeabi_llsl (Thumb, 30 bytes, Stack size 0 bytes, llshl.o(.text))

[Called By]

- >> _double_epilogue
- >> __aeabi_dadd
- >> __aeabi_d2ulz
- >> __aeabi_uldivmod

_ll_shift_l (Thumb, 0 bytes, Stack size 0 bytes, llshl.o(.text), UNUSED)

__aeabi_llsr (Thumb, 32 bytes, Stack size 0 bytes, llushr.o(.text))

[Called By]

- >> _double_epilogue
- >> __aeabi_d2ulz
- >> __aeabi_uldivmod

_ll_ushift_r (Thumb, 0 bytes, Stack size 0 bytes, llushr.o(.text), UNUSED)

__I$use$fp (Thumb, 0 bytes, Stack size 48 bytes, iusefp.o(.text), UNUSED)

__aeabi_dadd (Thumb, 322 bytes, Stack size 48 bytes, dadd.o(.text), UNUSED)

[Calls]

- >> __aeabi_lasr
- >> _double_round
- >> _double_epilogue
- >> __aeabi_llsl

[Called By]

- >> __aeabi_drsub
- >> __aeabi_dsub
- >> _fp_digits

__aeabi_dsub (Thumb, 6 bytes, Stack size 0 bytes, dadd.o(.text), UNUSED)

[Calls]

- >> __aeabi_dadd

__aeabi_drsub (Thumb, 6 bytes, Stack size 0 bytes, dadd.o(.text), UNUSED)

[Calls]

- >> __aeabi_dadd

__aeabi_dmul (Thumb, 228 bytes, Stack size 48 bytes, dmul.o(.text), UNUSED)

[Calls]

- >> _double_epilogue

[Called By]

- >> _fp_digits

__aeabi_ddiv (Thumb, 222 bytes, Stack size 32 bytes, ddiv.o(.text), UNUSED)

[Calls]

- >> _double_round

[Called By]

- >> _fp_digits

__aeabi_d2ulz (Thumb, 48 bytes, Stack size 0 bytes, dfixul.o(.text), UNUSED)

[Calls]

- >> __aeabi_llsr
- >> __aeabi_llsl

[Called By]

- >> _fp_digits

__aeabi_cdrcmple (Thumb, 48 bytes, Stack size 0 bytes, cdrcmple.o(.text), UNUSED)

[Called By]

- >> _fp_digits

__scatterload (Thumb, 28 bytes, Stack size 0 bytes, init.o(.text))

[Calls]

- >> __main_after_scatterload

[Called By]

- >> _main_scatterload

__scatterload_rt2 (Thumb, 0 bytes, Stack size 0 bytes, init.o(.text), UNUSED)

__aeabi_lasr (Thumb, 36 bytes, Stack size 0 bytes, llsshr.o(.text), UNUSED)

[Called By]

- >> __aeabi_dadd

_ll_sshift_r (Thumb, 0 bytes, Stack size 0 bytes, llsshr.o(.text), UNUSED)

_double_round (Thumb, 30 bytes, Stack size 8 bytes, depilogue.o(.text), UNUSED)

[Called By]

- >> _double_epilogue
- >> __aeabi_ddiv
- >> __aeabi_dadd

_double_epilogue (Thumb, 156 bytes, Stack size 32 bytes, depilogue.o(.text), UNUSED)

[Calls]

- >> _double_round
- >> __aeabi_llsr
- >> __aeabi_llsl

[Called By]

- >> __aeabi_dmul
- >> __aeabi_dadd

BootLoader_Clear (Thumb, 74 bytes, Stack size 8 bytes, tasktest.o(i.BootLoader_Clear))

[Stack]

- Max Depth = 52
- Call Chain = BootLoader_Clear ⇒ HAL_UART_MspDeInit ⇒ HAL_GPIO_DeInit

[Calls]

- >> HAL_UART_MspDeInit
- >> HAL_SPI_MspDeInit
- >> HAL_I2C_MspDeInit
- >> HAL_DeInit

[Called By]

- >> Load_A

BusFault_Handler (Thumb, 2 bytes, Stack size 0 bytes, stm32f4xx_it.o(i.BusFault_Handler))

[Calls]

- >> BusFault_Handler

[Called By]

- >> BusFault_Handler

[Address Reference Count : 1]

- startup_stm32f407xx.o(RESET)

DMA1_Stream5_IRQHandler (Thumb, 6 bytes, Stack size 0 bytes, stm32f4xx_it.o(i.DMA1_Stream5_IRQHandler))

[Stack]

- Max Depth = 32
- Call Chain = DMA1_Stream5_IRQHandler ⇒ HAL_DMA_IRQHandler

[Calls]

- >> HAL_DMA_IRQHandler

[Address Reference Count : 1]

- startup_stm32f407xx.o(RESET)

DMA1_Stream6_IRQHandler (Thumb, 6 bytes, Stack size 0 bytes, stm32f4xx_it.o(i.DMA1_Stream6_IRQHandler))

[Stack]

- Max Depth = 32
- Call Chain = DMA1_Stream6_IRQHandler ⇒ HAL_DMA_IRQHandler

[Calls]

- >> HAL_DMA_IRQHandler

[Address Reference Count : 1]

- startup_stm32f407xx.o(RESET)

DMA2_Stream2_IRQHandler (Thumb, 6 bytes, Stack size 0 bytes, stm32f4xx_it.o(i.DMA2_Stream2_IRQHandler))

[Stack]

- Max Depth = 32
- Call Chain = DMA2_Stream2_IRQHandler ⇒ HAL_DMA_IRQHandler

[Calls]

- >> HAL_DMA_IRQHandler

[Address Reference Count : 1]

- startup_stm32f407xx.o(RESET)

DebugMon_Handler (Thumb, 2 bytes, Stack size 0 bytes, stm32f4xx_it.o(i.DebugMon_Handler))
[Address Reference Count : 1]

- startup_stm32f407xx.o(RESET)

EP24C_WriteLongData (Thumb, 142 bytes, Stack size 48 bytes, at24c02.o(i.EP24C_WriteLongData))

[Stack]

- Max Depth = 176
- Call Chain = EP24C_WriteLongData ⇒ HAL_I2C_Mem_Write ⇒ I2C_RequestMemoryWrite ⇒ I2C_WaitOnMasterAddressFlagUntilTimeout

[Calls]

- >> HAL_I2C_Mem_Write
- >> HAL_Delay

[Called By]

- >> OTA_ProcessFrame

Error_Handler (Thumb, 4 bytes, Stack size 0 bytes, main.o(i.Error_Handler))

[Called By]

- >> HAL_UART_MspInit
- >> MX_USART2_UART_Init
- >> MX_USART1_UART_Init
- >> MX_SPI1_Init
- >> MX_I2C1_Init
- >> MX_CRC_Init
- >> SystemClock_Config

FLASH_Erase_Sector (Thumb, 76 bytes, Stack size 0 bytes, stm32f4xx_hal_flash_ex.o(i.FLASH_Erase_Sector))

[Called By]

- >> HAL_FLASHEx_Erase

FLASH_FlushCaches (Thumb, 80 bytes, Stack size 0 bytes, stm32f4xx_hal_flash_ex.o(i.FLASH_FlushCaches))

[Called By]

- >> HAL_FLASHEx_Erase

FLASH_WaitForLastOperation (Thumb, 76 bytes, Stack size 16 bytes, stm32f4xx_hal_flash.o(i.FLASH_WaitForLastOperation))

[Stack]

- Max Depth = 16
- Call Chain = FLASH_WaitForLastOperation

[Calls]

- >> FLASH_SetErrorCode
- >> HAL_GetTick

[Called By]

- >> HAL_FLASHEx_Erase
- >> HAL_FLASH_Program

HAL_CRC_Init (Thumb, 36 bytes, Stack size 8 bytes, stm32f4xx_hal_crc.o(i.HAL_CRC_Init))

[Stack]

- Max Depth = 16
- Call Chain = HAL_CRC_Init ⇒ HAL_CRC_MspInit

[Calls]

- >> HAL_CRC_MspInit

[Called By]

- >> MX_CRC_Init

HAL_CRC_MspInit (Thumb, 30 bytes, Stack size 8 bytes, crc.o(i.HAL_CRC_MspInit))

[Stack]

- Max Depth = 8
- Call Chain = HAL_CRC_MspInit

[Called By]

- >> HAL_CRC_Init

HAL_DMA_Abort (Thumb, 142 bytes, Stack size 24 bytes, stm32f4xx_hal_dma.o(i.HAL_DMA_Abort))

[Stack]

- Max Depth = 24
- Call Chain = HAL_DMA_Abort

[Calls]

- >> HAL_GetTick

[Called By]

- >> HAL_UART_IRQHandler
- >> HAL_UART_AbortReceive

HAL_DMA_Abort_IT (Thumb, 36 bytes, Stack size 0 bytes, stm32f4xx_hal_dma.o(i.HAL_DMA_Abort_IT))

[Called By]

- >> HAL_UART_IRQHandler

HAL_DMA_DeInit (Thumb, 102 bytes, Stack size 16 bytes, stm32f4xx_hal_dma.o(i.HAL_DMA_DeInit))

[Stack]

- Max Depth = 16
- Call Chain = HAL_DMA_DeInit

[Calls]

- >> DMA_CalcBaseAndBitshift

[Called By]

- >> HAL_UART_MspDeInit

HAL_DMA_GetError (Thumb, 4 bytes, Stack size 0 bytes, stm32f4xx_hal_dma.o(i.HAL_DMA_GetError))

[Called By]

- >> HAL_UART_AbortReceive

HAL_DMA_IRQHandler (Thumb, 460 bytes, Stack size 32 bytes, stm32f4xx_hal_dma.o(i.HAL_DMA_IRQHandler))

[Stack]

- Max Depth = 32
- Call Chain = HAL_DMA_IRQHandler

[Called By]

- >> DMA2_Stream2_IRQHandler
- >> DMA1_Stream6_IRQHandler
- >> DMA1_Stream5_IRQHandler

HAL_DMA_Init (Thumb, 208 bytes, Stack size 24 bytes, stm32f4xx_hal_dma.o(i.HAL_DMA_Init))

[Stack]

- Max Depth = 32
- Call Chain = HAL_DMA_Init ⇒ DMA_CheckFifoParam

[Calls]

- >> DMA_CheckFifoParam
- >> DMA_CalcBaseAndBitshift
- >> HAL_GetTick

[Called By]

- >> HAL_UART_MspInit

HAL_DMA_Start_IT (Thumb, 110 bytes, Stack size 24 bytes, stm32f4xx_hal_dma.o(i.HAL_DMA_Start_IT))

[Stack]

- Max Depth = 36
- Call Chain = HAL_DMA_Start_IT ⇒ DMA_SetConfig

[Calls]

- >> DMA_SetConfig

[Called By]

- >> UART_Start_Receive_DMA

HAL_DeInit (Thumb, 48 bytes, Stack size 8 bytes, stm32f4xx_hal.o(i.HAL_DeInit))

[Stack]

- Max Depth = 8
- Call Chain = HAL_DeInit

[Calls]

- >> HAL_MspDeInit

[Called By]

- >> BootLoader_Clear

HAL_Delay (Thumb, 32 bytes, Stack size 16 bytes, stm32f4xx_hal.o(i.HAL_Delay))

[Stack]

- Max Depth = 16
- Call Chain = HAL_Delay

[Calls]

- >> HAL_GetTick

[Called By]

- >> OTA_WaitForHandshake
- >> OTA_RunUpgradeProcess
- >> EP24C_WriteLongData

HAL_FLASHEx_Erase (Thumb, 150 bytes, Stack size 32 bytes, stm32f4xx_hal_flash_ex.o(i.HAL_FLASHEx_Erase))

[Stack]

- Max Depth = 48
- Call Chain = HAL_FLASHEx_Erase ⇒ FLASH_WaitForLastOperation

[Calls]

- >> FLASH_MassErase
- >> FLASH_FlushCaches
- >> FLASH_Erase_Sector
- >> FLASH_WaitForLastOperation

[Called By]

- >> MyFlash_EraseSectors

HAL_FLASH_Lock (Thumb, 14 bytes, Stack size 0 bytes, stm32f4xx_hal_flash.o(i.HAL_FLASH_Lock))

[Called By]

- >> MyFlash_WriteWord
- >> MyFlash_EraseSectors

HAL_FLASH_Program (Thumb, 116 bytes, Stack size 32 bytes, stm32f4xx_hal_flash.o(i.HAL_FLASH_Program))

[Stack]

- Max Depth = 48
- Call Chain = HAL_FLASH_Program ⇒ FLASH_WaitForLastOperation

[Calls]

- >> FLASH_WaitForLastOperation
- >> FLASH_Program_Word
- >> FLASH_Program_HalfWord
- >> FLASH_Program_DoubleWord
- >> FLASH_Program_Byte

[Called By]

- >> MyFlash_WriteWord

HAL_FLASH_Unlock (Thumb, 32 bytes, Stack size 0 bytes, stm32f4xx_hal_flash.o(i.HAL_FLASH_Unlock))

[Called By]

- >> MyFlash_WriteWord
- >> MyFlash_EraseSectors

HAL_GPIO_DeInit (Thumb, 276 bytes, Stack size 36 bytes, stm32f4xx_hal_gpio.o(i.HAL_GPIO_DeInit))

[Stack]

- Max Depth = 36
- Call Chain = HAL_GPIO_DeInit

[Called By]

- >> HAL_UART_MspDeInit
- >> HAL_SPI_MspDeInit
- >> HAL_I2C_MspDeInit

HAL_GPIO_Init (Thumb, 420 bytes, Stack size 40 bytes, stm32f4xx_hal_gpio.o(i.HAL_GPIO_Init))

[Stack]

- Max Depth = 40
- Call Chain = HAL_GPIO_Init

[Called By]

- >> HAL_UART_MspInit
- >> HAL_SPI_MspInit
- >> HAL_I2C_MspInit
- >> MX_GPIO_Init

HAL_GPIO_WritePin (Thumb, 14 bytes, Stack size 0 bytes, stm32f4xx_hal_gpio.o(i.HAL_GPIO_WritePin))

[Called By]

- >> MX_GPIO_Init

HAL_GetTick (Thumb, 6 bytes, Stack size 0 bytes, stm32f4xx_hal.o(i.HAL_GetTick))

[Called By]

- >> HAL_DMA_Init
- >> HAL_RCC_OscConfig
- >> HAL_RCC_ClockConfig
- >> HAL_DMA_Abort
- >> FLASH_WaitForLastOperation
- >> HAL_I2C_Mem_Write
- >> I2C_WaitOnTXEFlagUntilTimeout
- >> I2C_WaitOnMasterAddressFlagUntilTimeout
- >> I2C_WaitOnFlagUntilTimeout
- >> I2C_WaitOnBTFFlagUntilTimeout
- >> HAL_Delay
- >> OTA_WaitForHandshake
- >> HAL_UART_Transmit
- >> UART_WaitOnFlagUntilTimeout

HAL_I2C_Init (Thumb, 392 bytes, Stack size 16 bytes, stm32f4xx_hal_i2c.o(i.HAL_I2C_Init))

[Stack]

- Max Depth = 88
- Call Chain = HAL_I2C_Init ⇒ HAL_I2C_MspInit ⇒ HAL_GPIO_Init

[Calls]

- >> HAL_I2C_MspInit
- >> HAL_RCC_GetPCLK1Freq

[Called By]

- >> MX_I2C1_Init

HAL_I2C_Mem_Write (Thumb, 316 bytes, Stack size 64 bytes, stm32f4xx_hal_i2c.o(i.HAL_I2C_Mem_Write))

[Stack]

- Max Depth = 128
- Call Chain = HAL_I2C_Mem_Write ⇒ I2C_RequestMemoryWrite ⇒ I2C_WaitOnMasterAddressFlagUntilTimeout

[Calls]

- >> HAL_GetTick
- >> I2C_WaitOnTXEFlagUntilTimeout
- >> I2C_WaitOnFlagUntilTimeout
- >> I2C_WaitOnBTFFlagUntilTimeout
- >> I2C_RequestMemoryWrite

[Called By]

- >> EP24C_WriteLongData

HAL_I2C_MspDeInit (Thumb, 44 bytes, Stack size 8 bytes, i2c.o(i.HAL_I2C_MspDeInit))

[Stack]

- Max Depth = 44
- Call Chain = HAL_I2C_MspDeInit ⇒ HAL_GPIO_DeInit

[Calls]

- >> HAL_GPIO_DeInit

[Called By]

- >> BootLoader_Clear

HAL_I2C_MspInit (Thumb, 94 bytes, Stack size 32 bytes, i2c.o(i.HAL_I2C_MspInit))

[Stack]

- Max Depth = 72
- Call Chain = HAL_I2C_MspInit ⇒ HAL_GPIO_Init

[Calls]

- >> HAL_GPIO_Init
- >> __aeabi_memclr4

[Called By]

- >> HAL_I2C_Init

HAL_IncTick (Thumb, 12 bytes, Stack size 0 bytes, stm32f4xx_hal.o(i.HAL_IncTick))

[Called By]

- >> SysTick_Handler

HAL_Init (Thumb, 48 bytes, Stack size 8 bytes, stm32f4xx_hal.o(i.HAL_Init))

[Stack]

- Max Depth = 40
- Call Chain = HAL_Init ⇒ HAL_InitTick ⇒ HAL_NVIC_SetPriority

[Calls]

- >> HAL_MspInit
- >> HAL_InitTick
- >> HAL_NVIC_SetPriorityGrouping

[Called By]

- >> main

HAL_InitTick (Thumb, 58 bytes, Stack size 16 bytes, stm32f4xx_hal.o(i.HAL_InitTick))

[Stack]

- Max Depth = 32
- Call Chain = HAL_InitTick ⇒ HAL_NVIC_SetPriority

[Calls]

- >> HAL_NVIC_SetPriority
- >> HAL_SYSTICK_Config

[Called By]

- >> HAL_RCC_ClockConfig
- >> HAL_Init

HAL_MspDeInit (Thumb, 2 bytes, Stack size 0 bytes, stm32f4xx_hal.o(i.HAL_MspDeInit))

[Called By]

- >> HAL_DeInit

HAL_MspInit (Thumb, 42 bytes, Stack size 8 bytes, stm32f4xx_hal_msp.o(i.HAL_MspInit))

[Stack]

- Max Depth = 8
- Call Chain = HAL_MspInit

[Called By]

- >> HAL_Init

HAL_NVIC_DisableIRQ (Thumb, 34 bytes, Stack size 0 bytes, stm32f4xx_hal_cortex.o(i.HAL_NVIC_DisableIRQ))

[Called By]

- >> HAL_UART_MspDeInit

HAL_NVIC_EnableIRQ (Thumb, 26 bytes, Stack size 0 bytes, stm32f4xx_hal_cortex.o(i.HAL_NVIC_EnableIRQ))

[Called By]

- >> HAL_UART_MspInit
- >> MX_DMA_Init

HAL_NVIC_SetPriority (Thumb, 60 bytes, Stack size 16 bytes, stm32f4xx_hal_cortex.o(i.HAL_NVIC_SetPriority))

[Stack]

- Max Depth = 16
- Call Chain = HAL_NVIC_SetPriority

[Calls]

- >> __NVIC_SetPriority

[Called By]

- >> HAL_UART_MspInit
- >> MX_DMA_Init
- >> HAL_InitTick

HAL_NVIC_SetPriorityGrouping (Thumb, 26 bytes, Stack size 0 bytes, stm32f4xx_hal_cortex.o(i.HAL_NVIC_SetPriorityGrouping))

[Called By]

- >> HAL_Init

HAL_RCC_ClockConfig (Thumb, 310 bytes, Stack size 32 bytes, stm32f4xx_hal_rcc.o(i.HAL_RCC_ClockConfig))

[Stack]

- Max Depth = 80
- Call Chain = HAL_RCC_ClockConfig ⇒ HAL_RCC_GetSysClockFreq ⇒ __aeabi_uldivmod

[Calls]

- >> HAL_RCC_GetSysClockFreq
- >> HAL_InitTick
- >> HAL_GetTick

[Called By]

- >> SystemClock_Config

HAL_RCC_GetHCLKFreq (Thumb, 6 bytes, Stack size 0 bytes, stm32f4xx_hal_rcc.o(i.HAL_RCC_GetHCLKFreq))

[Called By]

- >> HAL_RCC_GetPCLK2Freq
- >> HAL_RCC_GetPCLK1Freq

HAL_RCC_GetPCLK1Freq (Thumb, 22 bytes, Stack size 4 bytes, stm32f4xx_hal_rcc.o(i.HAL_RCC_GetPCLK1Freq))

[Stack]

- Max Depth = 4
- Call Chain = HAL_RCC_GetPCLK1Freq

[Calls]

- >> HAL_RCC_GetHCLKFreq

[Called By]

- >> HAL_I2C_Init
- >> UART_SetConfig

HAL_RCC_GetPCLK2Freq (Thumb, 22 bytes, Stack size 4 bytes, stm32f4xx_hal_rcc.o(i.HAL_RCC_GetPCLK2Freq))

[Stack]

- Max Depth = 4
- Call Chain = HAL_RCC_GetPCLK2Freq

[Calls]

- >> HAL_RCC_GetHCLKFreq

[Called By]

- >> UART_SetConfig

HAL_RCC_GetSysClockFreq (Thumb, 94 bytes, Stack size 8 bytes, stm32f4xx_hal_rcc.o(i.HAL_RCC_GetSysClockFreq))

[Stack]

- Max Depth = 48
- Call Chain = HAL_RCC_GetSysClockFreq ⇒ __aeabi_uldivmod

[Calls]

- >> __aeabi_uldivmod

[Called By]

- >> HAL_RCC_ClockConfig

HAL_RCC_OscConfig (Thumb, 942 bytes, Stack size 40 bytes, stm32f4xx_hal_rcc.o(i.HAL_RCC_OscConfig))

[Stack]

- Max Depth = 40
- Call Chain = HAL_RCC_OscConfig

[Calls]

- >> HAL_GetTick

[Called By]

- >> SystemClock_Config

HAL_SPI_Init (Thumb, 190 bytes, Stack size 16 bytes, stm32f4xx_hal_spi.o(i.HAL_SPI_Init))

[Stack]

- Max Depth = 88
- Call Chain = HAL_SPI_Init ⇒ HAL_SPI_MspInit ⇒ HAL_GPIO_Init

[Calls]

- >> HAL_SPI_MspInit

[Called By]

- >> MX_SPI1_Init

HAL_SPI_MspDeInit (Thumb, 28 bytes, Stack size 0 bytes, spi.o(i.HAL_SPI_MspDeInit))

[Stack]

- Max Depth = 36
- Call Chain = HAL_SPI_MspDeInit ⇒ HAL_GPIO_DeInit

[Calls]

- >> HAL_GPIO_DeInit

[Called By]

- >> BootLoader_Clear

HAL_SPI_MspInit (Thumb, 92 bytes, Stack size 32 bytes, spi.o(i.HAL_SPI_MspInit))

[Stack]

- Max Depth = 72
- Call Chain = HAL_SPI_MspInit ⇒ HAL_GPIO_Init

[Calls]

- >> HAL_GPIO_Init
- >> __aeabi_memclr4

[Called By]

- >> HAL_SPI_Init

HAL_SYSTICK_Config (Thumb, 40 bytes, Stack size 8 bytes, stm32f4xx_hal_cortex.o(i.HAL_SYSTICK_Config))

[Stack]

- Max Depth = 8
- Call Chain = HAL_SYSTICK_Config

[Calls]

- >> __NVIC_SetPriority

[Called By]

- >> HAL_InitTick

HAL_UARTEx_RxEventCallback (Thumb, 2 bytes, Stack size 0 bytes, stm32f4xx_hal_uart.o(i.HAL_UARTEx_RxEventCallback))

[Called By]

- >> HAL_UART_IRQHandler
- >> UART_Receive_IT
- >> UART_DMARxHalfCplt
- >> UART_DMAReceiveCplt

HAL_UART_AbortReceive (Thumb, 148 bytes, Stack size 16 bytes, stm32f4xx_hal_uart.o(i.HAL_UART_AbortReceive))

[Stack]

- Max Depth = 40
- Call Chain = HAL_UART_AbortReceive ⇒ HAL_DMA_Abort

[Calls]

- >> HAL_DMA_GetError
- >> HAL_DMA_Abort

[Called By]

- >> UART_IDLE_CallBack
- >> U1RXBootLoader_IDLE_CallBack

HAL_UART_ErrorCallback (Thumb, 2 bytes, Stack size 0 bytes, stm32f4xx_hal_uart.o(i.HAL_UART_ErrorCallback))

[Called By]

- >> HAL_UART_IRQHandler
- >> UART_DMAError
- >> UART_DMAAbortOnError

HAL_UART_IRQHandler (Thumb, 546 bytes, Stack size 24 bytes, stm32f4xx_hal_uart.o(i.HAL_UART_IRQHandler))

[Stack]

- Max Depth = 48
- Call Chain = HAL_UART_IRQHandler ⇒ HAL_DMA_Abort

[Calls]

- >> HAL_DMA_Abort_IT
- >> HAL_DMA_Abort
- >> HAL_UART_ErrorCallback
- >> HAL_UARTEx_RxEventCallback
- >> UART_Transmit_IT
- >> UART_Receive_IT
- >> UART_EndTransmit_IT
- >> UART_EndRxTransfer

[Called By]

- >> USART2_IRQHandler
- >> USART1_IRQHandler

HAL_UART_Init (Thumb, 100 bytes, Stack size 16 bytes, stm32f4xx_hal_uart.o(i.HAL_UART_Init))

[Stack]

- Max Depth = 112
- Call Chain = HAL_UART_Init ⇒ HAL_UART_MspInit ⇒ HAL_GPIO_Init

[Calls]

- >> HAL_UART_MspInit
- >> UART_SetConfig

[Called By]

- >> MX_USART2_UART_Init
- >> MX_USART1_UART_Init

HAL_UART_MspDeInit (Thumb, 100 bytes, Stack size 8 bytes, usart.o(i.HAL_UART_MspDeInit))

[Stack]

- Max Depth = 44
- Call Chain = HAL_UART_MspDeInit ⇒ HAL_GPIO_DeInit

[Calls]

- >> HAL_NVIC_DisableIRQ
- >> HAL_DMA_DeInit
- >> HAL_GPIO_DeInit

[Called By]

- >> BootLoader_Clear

HAL_UART_MspInit (Thumb, 362 bytes, Stack size 56 bytes, usart.o(i.HAL_UART_MspInit))

[Stack]

- Max Depth = 96
- Call Chain = HAL_UART_MspInit ⇒ HAL_GPIO_Init

[Calls]

- >> HAL_DMA_Init
- >> HAL_NVIC_SetPriority
- >> HAL_NVIC_EnableIRQ
- >> HAL_GPIO_Init
- >> Error_Handler
- >> __aeabi_memclr4

[Called By]

- >> HAL_UART_Init

HAL_UART_Receive_DMA (Thumb, 46 bytes, Stack size 0 bytes, stm32f4xx_hal_uart.o(i.HAL_UART_Receive_DMA))

[Stack]

- Max Depth = 68
- Call Chain = HAL_UART_Receive_DMA ⇒ UART_Start_Receive_DMA ⇒ HAL_DMA_Start_IT ⇒ DMA_SetConfig

[Calls]

- >> UART_Start_Receive_DMA

[Called By]

- >> UART_IDLE_CallBack
- >> U1RXBootLoader_IDLE_CallBack
- >> UART_circular_buffer_Init
- >> U1BootLoader_Init

HAL_UART_RxCpltCallback (Thumb, 2 bytes, Stack size 0 bytes, stm32f4xx_hal_uart.o(i.HAL_UART_RxCpltCallback))

[Called By]

- >> UART_Receive_IT
- >> UART_DMAReceiveCplt

HAL_UART_RxHalfCpltCallback (Thumb, 2 bytes, Stack size 0 bytes, stm32f4xx_hal_uart.o(i.HAL_UART_RxHalfCpltCallback))

[Called By]

- >> UART_DMARxHalfCplt

HAL_UART_Transmit (Thumb, 190 bytes, Stack size 32 bytes, stm32f4xx_hal_uart.o(i.HAL_UART_Transmit))

[Stack]

- Max Depth = 56
- Call Chain = HAL_UART_Transmit ⇒ UART_WaitOnFlagUntilTimeout

[Calls]

- >> HAL_GetTick
- >> UART_WaitOnFlagUntilTimeout

[Called By]

- >> U1_Printf
- >> OTA_SendSimpleFrame

HAL_UART_TxCpltCallback (Thumb, 2 bytes, Stack size 0 bytes, stm32f4xx_hal_uart.o(i.HAL_UART_TxCpltCallback))

[Called By]

- >> UART_EndTransmit_IT

HardFault_Handler (Thumb, 2 bytes, Stack size 0 bytes, stm32f4xx_it.o(i.HardFault_Handler))

[Calls]

- >> HardFault_Handler

[Called By]

- >> HardFault_Handler

[Address Reference Count : 1]

- startup_stm32f407xx.o(RESET)

Load_A (Thumb, 128 bytes, Stack size 8 bytes, tasktest.o(i.Load_A))

[Stack]

- Max Depth = 88
- Call Chain = Load_A ⇒ U1_Printf ⇒ HAL_UART_Transmit ⇒ UART_WaitOnFlagUntilTimeout

[Calls]

- >> U1_Printf
- >> BootLoader_Clear
- >> MSR_SP

[Called By]

- >> OTA_RunUpgradeProcess

MX_CRC_Init (Thumb, 28 bytes, Stack size 8 bytes, crc.o(i.MX_CRC_Init))

[Stack]

- Max Depth = 24
- Call Chain = MX_CRC_Init ⇒ HAL_CRC_Init ⇒ HAL_CRC_MspInit

[Calls]

- >> HAL_CRC_Init
- >> Error_Handler

[Called By]

- >> main

MX_DMA_Init (Thumb, 88 bytes, Stack size 8 bytes, dma.o(i.MX_DMA_Init))

[Stack]

- Max Depth = 24
- Call Chain = MX_DMA_Init ⇒ HAL_NVIC_SetPriority

[Calls]

- >> HAL_NVIC_SetPriority
- >> HAL_NVIC_EnableIRQ

[Called By]

- >> main

MX_GPIO_Init (Thumb, 116 bytes, Stack size 40 bytes, gpio.o(i.MX_GPIO_Init))

[Stack]

- Max Depth = 80
- Call Chain = MX_GPIO_Init ⇒ HAL_GPIO_Init

[Calls]

- >> HAL_GPIO_WritePin
- >> HAL_GPIO_Init
- >> __aeabi_memclr4

[Called By]

- >> main

MX_I2C1_Init (Thumb, 50 bytes, Stack size 8 bytes, i2c.o(i.MX_I2C1_Init))

[Stack]

- Max Depth = 96
- Call Chain = MX_I2C1_Init ⇒ HAL_I2C_Init ⇒ HAL_I2C_MspInit ⇒ HAL_GPIO_Init

[Calls]

- >> HAL_I2C_Init
- >> Error_Handler

[Called By]

- >> main

MX_SPI1_Init (Thumb, 62 bytes, Stack size 8 bytes, spi.o(i.MX_SPI1_Init))

[Stack]

- Max Depth = 96
- Call Chain = MX_SPI1_Init ⇒ HAL_SPI_Init ⇒ HAL_SPI_MspInit ⇒ HAL_GPIO_Init

[Calls]

- >> HAL_SPI_Init
- >> Error_Handler

[Called By]

- >> main

MX_USART1_UART_Init (Thumb, 48 bytes, Stack size 8 bytes, usart.o(i.MX_USART1_UART_Init))

[Stack]

- Max Depth = 120
- Call Chain = MX_USART1_UART_Init ⇒ HAL_UART_Init ⇒ HAL_UART_MspInit ⇒ HAL_GPIO_Init

[Calls]

- >> HAL_UART_Init
- >> Error_Handler

[Called By]

- >> main

MX_USART2_UART_Init (Thumb, 48 bytes, Stack size 8 bytes, usart.o(i.MX_USART2_UART_Init))

[Stack]

- Max Depth = 120
- Call Chain = MX_USART2_UART_Init ⇒ HAL_UART_Init ⇒ HAL_UART_MspInit ⇒ HAL_GPIO_Init

[Calls]

- >> HAL_UART_Init
- >> Error_Handler

[Called By]

- >> main

MemManage_Handler (Thumb, 2 bytes, Stack size 0 bytes, stm32f4xx_it.o(i.MemManage_Handler))

[Calls]

- >> MemManage_Handler

[Called By]

- >> MemManage_Handler

[Address Reference Count : 1]

- startup_stm32f407xx.o(RESET)

MyFlash_EraseSectors (Thumb, 80 bytes, Stack size 40 bytes, myflash.o(i.MyFlash_EraseSectors))

[Stack]

- Max Depth = 120
- Call Chain = MyFlash_EraseSectors ⇒ U1_Printf ⇒ HAL_UART_Transmit ⇒ UART_WaitOnFlagUntilTimeout

[Calls]

- >> U1_Printf
- >> HAL_FLASHEx_Erase
- >> HAL_FLASH_Unlock
- >> HAL_FLASH_Lock

[Called By]

- >> OTA_EraseAppRegion

MyFlash_WriteBuffer (Thumb, 82 bytes, Stack size 24 bytes, myflash.o(i.MyFlash_WriteBuffer))

[Stack]

- Max Depth = 88
- Call Chain = MyFlash_WriteBuffer ⇒ MyFlash_WriteWord ⇒ HAL_FLASH_Program ⇒ FLASH_WaitForLastOperation

[Calls]

- >> MyFlash_WriteWord

[Called By]

- >> OTA_WriteFirmwareData

MyFlash_WriteWord (Thumb, 48 bytes, Stack size 16 bytes, myflash.o(i.MyFlash_WriteWord))

[Stack]

- Max Depth = 64
- Call Chain = MyFlash_WriteWord ⇒ HAL_FLASH_Program ⇒ FLASH_WaitForLastOperation

[Calls]

- >> HAL_FLASH_Unlock
- >> HAL_FLASH_Program
- >> HAL_FLASH_Lock

[Called By]

- >> MyFlash_WriteBuffer

NMI_Handler (Thumb, 2 bytes, Stack size 0 bytes, stm32f4xx_it.o(i.NMI_Handler))

[Calls]

- >> NMI_Handler

[Called By]

- >> NMI_Handler

[Address Reference Count : 1]

- startup_stm32f407xx.o(RESET)

OTA_CalcCRC32 (Thumb, 148 bytes, Stack size 12 bytes, tasktest.o(i.OTA_CalcCRC32))

[Stack]

- Max Depth = 12
- Call Chain = OTA_CalcCRC32

[Called By]

- >> OTA_ParseDataFrame

OTA_EraseAppRegion (Thumb, 48 bytes, Stack size 8 bytes, tasktest.o(i.OTA_EraseAppRegion))

[Stack]

- Max Depth = 128
- Call Chain = OTA_EraseAppRegion ⇒ MyFlash_EraseSectors ⇒ U1_Printf ⇒ HAL_UART_Transmit ⇒ UART_WaitOnFlagUntilTimeout

[Calls]

- >> U1_Printf
- >> MyFlash_EraseSectors

[Called By]

- >> OTA_ProcessFrame

OTA_Init (Thumb, 70 bytes, Stack size 8 bytes, tasktest.o(i.OTA_Init))

[Stack]

- Max Depth = 88
- Call Chain = OTA_Init ⇒ U1_Printf ⇒ HAL_UART_Transmit ⇒ UART_WaitOnFlagUntilTimeout

[Calls]

- >> U1_Printf

[Called By]

- >> Task_Main

OTA_ParseDataFrame (Thumb, 264 bytes, Stack size 24 bytes, tasktest.o(i.OTA_ParseDataFrame))

[Stack]

- Max Depth = 104
- Call Chain = OTA_ParseDataFrame ⇒ U1_Printf ⇒ HAL_UART_Transmit ⇒ UART_WaitOnFlagUntilTimeout

[Calls]

- >> U1_Printf
- >> __aeabi_memcpy
- >> OTA_CalcCRC32

[Called By]

- >> OTA_ProcessFrame

OTA_ParseFirmwareInfo (Thumb, 252 bytes, Stack size 16 bytes, tasktest.o(i.OTA_ParseFirmwareInfo))

[Stack]

- Max Depth = 96
- Call Chain = OTA_ParseFirmwareInfo ⇒ U1_Printf ⇒ HAL_UART_Transmit ⇒ UART_WaitOnFlagUntilTimeout

[Calls]

- >> U1_Printf

[Called By]

- >> OTA_ProcessFrame

OTA_ParseSimpleFrame (Thumb, 42 bytes, Stack size 0 bytes, tasktest.o(i.OTA_ParseSimpleFrame))

[Called By]

- >> OTA_WaitForHandshake
- >> OTA_ProcessFrame

OTA_ProcessFrame (Thumb, 1748 bytes, Stack size 1088 bytes, tasktest.o(i.OTA_ProcessFrame))

[Stack]

- Max Depth = 2224
- Call Chain = OTA_ProcessFrame ⇒ OTA_WriteFirmwareData ⇒ MyFlash_WriteBuffer ⇒ MyFlash_WriteWord ⇒ HAL_FLASH_Program ⇒ FLASH_WaitForLastOperation

[Calls]

- >> U1_Printf
- >> OTA_WriteFirmwareData
- >> OTA_SendACK
- >> OTA_ParseSimpleFrame
- >> OTA_ParseFirmwareInfo
- >> OTA_ParseDataFrame
- >> OTA_EraseAppRegion
- >> EP24C_WriteLongData

[Called By]

- >> OTA_RunUpgradeProcess

OTA_RunUpgradeProcess (Thumb, 188 bytes, Stack size 24 bytes, tasktest.o(i.OTA_RunUpgradeProcess))

[Stack]

- Max Depth = 2248
- Call Chain = OTA_RunUpgradeProcess ⇒ OTA_ProcessFrame ⇒ OTA_WriteFirmwareData ⇒ MyFlash_WriteBuffer ⇒ MyFlash_WriteWord ⇒ HAL_FLASH_Program ⇒ FLASH_WaitForLastOperation

[Calls]

- >> U1_Printf
- >> HAL_Delay
- >> UART_circular_buffer_ReadData
- >> UART_circular_buffer_GetRxLen
- >> OTA_WaitForHandshake
- >> OTA_SendACK
- >> OTA_ProcessFrame
- >> Load_A

[Called By]

- >> Task_While

OTA_SendACK (Thumb, 6 bytes, Stack size 0 bytes, tasktest.o(i.OTA_SendACK))

[Stack]

- Max Depth = 64
- Call Chain = OTA_SendACK ⇒ OTA_SendSimpleFrame ⇒ HAL_UART_Transmit ⇒ UART_WaitOnFlagUntilTimeout

[Calls]

- >> OTA_SendSimpleFrame

[Called By]

- >> OTA_RunUpgradeProcess
- >> OTA_ProcessFrame

OTA_SendSimpleFrame (Thumb, 32 bytes, Stack size 8 bytes, tasktest.o(i.OTA_SendSimpleFrame))

[Stack]

- Max Depth = 64
- Call Chain = OTA_SendSimpleFrame ⇒ HAL_UART_Transmit ⇒ UART_WaitOnFlagUntilTimeout

[Calls]

- >> HAL_UART_Transmit

[Called By]

- >> OTA_SendACK

OTA_WaitForHandshake (Thumb, 92 bytes, Stack size 16 bytes, tasktest.o(i.OTA_WaitForHandshake))

[Stack]

- Max Depth = 96
- Call Chain = OTA_WaitForHandshake ⇒ U1_Printf ⇒ HAL_UART_Transmit ⇒ UART_WaitOnFlagUntilTimeout

[Calls]

- >> U1_Printf
- >> HAL_GetTick
- >> HAL_Delay
- >> UART_circular_buffer_ReadData
- >> UART_circular_buffer_GetRxLen
- >> OTA_ParseSimpleFrame

[Called By]

- >> OTA_RunUpgradeProcess

OTA_WriteFirmwareData (Thumb, 66 bytes, Stack size 1048 bytes, tasktest.o(i.OTA_WriteFirmwareData))

[Stack]

- Max Depth = 1136
- Call Chain = OTA_WriteFirmwareData ⇒ MyFlash_WriteBuffer ⇒ MyFlash_WriteWord ⇒ HAL_FLASH_Program ⇒ FLASH_WaitForLastOperation

[Calls]

- >> __aeabi_memset
- >> __aeabi_memcpy
- >> MyFlash_WriteBuffer

[Called By]

- >> OTA_ProcessFrame

PendSV_Handler (Thumb, 2 bytes, Stack size 0 bytes, stm32f4xx_it.o(i.PendSV_Handler))
[Address Reference Count : 1]

- startup_stm32f407xx.o(RESET)

SVC_Handler (Thumb, 2 bytes, Stack size 0 bytes, stm32f4xx_it.o(i.SVC_Handler))
[Address Reference Count : 1]

- startup_stm32f407xx.o(RESET)

SysTick_Handler (Thumb, 4 bytes, Stack size 0 bytes, stm32f4xx_it.o(i.SysTick_Handler))

[Calls]

- >> HAL_IncTick

[Address Reference Count : 1]

- startup_stm32f407xx.o(RESET)

SystemClock_Config (Thumb, 138 bytes, Stack size 88 bytes, main.o(i.SystemClock_Config))

[Stack]

- Max Depth = 168
- Call Chain = SystemClock_Config ⇒ HAL_RCC_ClockConfig ⇒ HAL_RCC_GetSysClockFreq ⇒ __aeabi_uldivmod

[Calls]

- >> HAL_RCC_OscConfig
- >> HAL_RCC_ClockConfig
- >> Error_Handler
- >> __aeabi_memclr4

[Called By]

- >> main

SystemInit (Thumb, 12 bytes, Stack size 0 bytes, system_stm32f4xx.o(i.SystemInit))
[Address Reference Count : 1]

- startup_stm32f407xx.o(.text)

Task_Main (Thumb, 14 bytes, Stack size 8 bytes, tasktest.o(i.Task_Main))

[Stack]

- Max Depth = 96
- Call Chain = Task_Main ⇒ OTA_Init ⇒ U1_Printf ⇒ HAL_UART_Transmit ⇒ UART_WaitOnFlagUntilTimeout

[Calls]

- >> UART_circular_buffer_Init
- >> OTA_Init

[Called By]

- >> main

Task_While (Thumb, 18 bytes, Stack size 0 bytes, tasktest.o(i.Task_While))

[Stack]

- Max Depth = 2248
- Call Chain = Task_While ⇒ OTA_RunUpgradeProcess ⇒ OTA_ProcessFrame ⇒ OTA_WriteFirmwareData ⇒ MyFlash_WriteBuffer ⇒ MyFlash_WriteWord ⇒ HAL_FLASH_Program ⇒ FLASH_WaitForLastOperation

[Calls]

- >> OTA_RunUpgradeProcess

[Called By]

- >> main

U1BootLoader_Init (Thumb, 38 bytes, Stack size 8 bytes, usart1_boot.o(i.U1BootLoader_Init))

[Stack]

- Max Depth = 76
- Call Chain = U1BootLoader_Init ⇒ HAL_UART_Receive_DMA ⇒ UART_Start_Receive_DMA ⇒ HAL_DMA_Start_IT ⇒ DMA_SetConfig

[Calls]

- >> UCBRx_PtrInit
- >> HAL_UART_Receive_DMA

[Called By]

- >> main

U1RXBootLoader_IDLE_CallBack (Thumb, 132 bytes, Stack size 24 bytes, usart1_boot.o(i.U1RXBootLoader_IDLE_CallBack))

[Stack]

- Max Depth = 92
- Call Chain = U1RXBootLoader_IDLE_CallBack ⇒ HAL_UART_Receive_DMA ⇒ UART_Start_Receive_DMA ⇒ HAL_DMA_Start_IT ⇒ DMA_SetConfig

[Calls]

- >> HAL_UART_Receive_DMA
- >> HAL_UART_AbortReceive

[Called By]

- >> USART1_IRQHandler

U1_Printf (Thumb, 58 bytes, Stack size 24 bytes, usart1_boot.o(i.U1_Printf))

[Stack]

- Max Depth = 80
- Call Chain = U1_Printf ⇒ HAL_UART_Transmit ⇒ UART_WaitOnFlagUntilTimeout

[Calls]

- >> vsnprintf
- >> HAL_UART_Transmit

[Called By]

- >> main
- >> MyFlash_EraseSectors
- >> OTA_WaitForHandshake
- >> OTA_RunUpgradeProcess
- >> OTA_ProcessFrame
- >> OTA_ParseFirmwareInfo
- >> OTA_ParseDataFrame
- >> OTA_Init
- >> OTA_EraseAppRegion
- >> Load_A

UART_IDLE_CallBack (Thumb, 114 bytes, Stack size 24 bytes, command.o(i.UART_IDLE_CallBack))

[Stack]

- Max Depth = 92
- Call Chain = UART_IDLE_CallBack ⇒ HAL_UART_Receive_DMA ⇒ UART_Start_Receive_DMA ⇒ HAL_DMA_Start_IT ⇒ DMA_SetConfig

[Calls]

- >> HAL_UART_Receive_DMA
- >> HAL_UART_AbortReceive

[Called By]

- >> USART2_IRQHandler

UART_Start_Receive_DMA (Thumb, 138 bytes, Stack size 32 bytes, stm32f4xx_hal_uart.o(i.UART_Start_Receive_DMA))

[Stack]

- Max Depth = 68
- Call Chain = UART_Start_Receive_DMA ⇒ HAL_DMA_Start_IT ⇒ DMA_SetConfig

[Calls]

- >> HAL_DMA_Start_IT

[Called By]

- >> HAL_UART_Receive_DMA

UART_circular_buffer_GetRxLen (Thumb, 34 bytes, Stack size 0 bytes, command.o(i.UART_circular_buffer_GetRxLen))

[Called By]

- >> UART_circular_buffer_ReadData
- >> OTA_WaitForHandshake
- >> OTA_RunUpgradeProcess

UART_circular_buffer_Init (Thumb, 36 bytes, Stack size 0 bytes, command.o(i.UART_circular_buffer_Init))

[Stack]

- Max Depth = 68
- Call Chain = UART_circular_buffer_Init ⇒ HAL_UART_Receive_DMA ⇒ UART_Start_Receive_DMA ⇒ HAL_DMA_Start_IT ⇒ DMA_SetConfig

[Calls]

- >> HAL_UART_Receive_DMA

[Called By]

- >> Task_Main
- >> main

UART_circular_buffer_ReadData (Thumb, 58 bytes, Stack size 12 bytes, command.o(i.UART_circular_buffer_ReadData))

[Stack]

- Max Depth = 12
- Call Chain = UART_circular_buffer_ReadData

[Calls]

- >> UART_circular_buffer_GetRxLen

[Called By]

- >> OTA_WaitForHandshake
- >> OTA_RunUpgradeProcess

UCBRx_PtrInit (Thumb, 26 bytes, Stack size 0 bytes, usart1_boot.o(i.UCBRx_PtrInit))

[Called By]

- >> U1BootLoader_Init

USART1_IRQHandler (Thumb, 18 bytes, Stack size 8 bytes, stm32f4xx_it.o(i.USART1_IRQHandler))

[Stack]

- Max Depth = 100
- Call Chain = USART1_IRQHandler ⇒ U1RXBootLoader_IDLE_CallBack ⇒ HAL_UART_Receive_DMA ⇒ UART_Start_Receive_DMA ⇒ HAL_DMA_Start_IT ⇒ DMA_SetConfig

[Calls]

- >> U1RXBootLoader_IDLE_CallBack
- >> HAL_UART_IRQHandler

[Address Reference Count : 1]

- startup_stm32f407xx.o(RESET)

USART2_IRQHandler (Thumb, 18 bytes, Stack size 8 bytes, stm32f4xx_it.o(i.USART2_IRQHandler))

[Stack]

- Max Depth = 100
- Call Chain = USART2_IRQHandler ⇒ UART_IDLE_CallBack ⇒ HAL_UART_Receive_DMA ⇒ UART_Start_Receive_DMA ⇒ HAL_DMA_Start_IT ⇒ DMA_SetConfig

[Calls]

- >> UART_IDLE_CallBack
- >> HAL_UART_IRQHandler

[Address Reference Count : 1]

- startup_stm32f407xx.o(RESET)

UsageFault_Handler (Thumb, 2 bytes, Stack size 0 bytes, stm32f4xx_it.o(i.UsageFault_Handler))

[Calls]

- >> UsageFault_Handler

[Called By]

- >> UsageFault_Handler

[Address Reference Count : 1]

- startup_stm32f407xx.o(RESET)

__0vsnprintf (Thumb, 46 bytes, Stack size 24 bytes, printfa.o(i.__0vsnprintf), UNUSED)

[Calls]

- >> _printf_core

__1vsnprintf (Thumb, 0 bytes, Stack size 24 bytes, printfa.o(i.__0vsnprintf), UNUSED)

__2vsnprintf (Thumb, 0 bytes, Stack size 24 bytes, printfa.o(i.__0vsnprintf), UNUSED)

__c89vsnprintf (Thumb, 0 bytes, Stack size 24 bytes, printfa.o(i.__0vsnprintf), UNUSED)

vsnprintf (Thumb, 0 bytes, Stack size 24 bytes, printfa.o(i.__0vsnprintf))

[Stack]

- Max Depth = 24
- Call Chain = vsnprintf

[Called By]

- >> U1_Printf

__scatterload_copy (Thumb, 14 bytes, Stack size unknown bytes, handlers.o(i.__scatterload_copy), UNUSED)

__scatterload_null (Thumb, 2 bytes, Stack size unknown bytes, handlers.o(i.__scatterload_null), UNUSED)

__scatterload_zeroinit (Thumb, 14 bytes, Stack size unknown bytes, handlers.o(i.__scatterload_zeroinit), UNUSED)

main (Thumb, 60 bytes, Stack size 0 bytes, main.o(i.main))

[Stack]

- Max Depth = 2248
- Call Chain = main ⇒ Task_While ⇒ OTA_RunUpgradeProcess ⇒ OTA_ProcessFrame ⇒ OTA_WriteFirmwareData ⇒ MyFlash_WriteBuffer ⇒ MyFlash_WriteWord ⇒ HAL_FLASH_Program ⇒ FLASH_WaitForLastOperation

[Calls]

- >> UART_circular_buffer_Init
- >> U1_Printf
- >> U1BootLoader_Init
- >> Task_While
- >> Task_Main
- >> MX_USART2_UART_Init
- >> MX_USART1_UART_Init
- >> MX_SPI1_Init
- >> MX_I2C1_Init
- >> MX_GPIO_Init
- >> MX_DMA_Init
- >> MX_CRC_Init
- >> HAL_Init
- >> SystemClock_Config

[Address Reference Count : 1]

- entry9a.o(.ARM.Collect$$$$0000000B)

### Local Symbols

FLASH_Program_Byte (Thumb, 26 bytes, Stack size 0 bytes, stm32f4xx_hal_flash.o(i.FLASH_Program_Byte))

[Called By]

- >> HAL_FLASH_Program

FLASH_Program_DoubleWord (Thumb, 38 bytes, Stack size 8 bytes, stm32f4xx_hal_flash.o(i.FLASH_Program_DoubleWord))

[Stack]

- Max Depth = 8
- Call Chain = FLASH_Program_DoubleWord

[Called By]

- >> HAL_FLASH_Program

FLASH_Program_HalfWord (Thumb, 30 bytes, Stack size 0 bytes, stm32f4xx_hal_flash.o(i.FLASH_Program_HalfWord))

[Called By]

- >> HAL_FLASH_Program

FLASH_Program_Word (Thumb, 30 bytes, Stack size 0 bytes, stm32f4xx_hal_flash.o(i.FLASH_Program_Word))

[Called By]

- >> HAL_FLASH_Program

FLASH_SetErrorCode (Thumb, 96 bytes, Stack size 0 bytes, stm32f4xx_hal_flash.o(i.FLASH_SetErrorCode))

[Called By]

- >> FLASH_WaitForLastOperation

FLASH_MassErase (Thumb, 34 bytes, Stack size 0 bytes, stm32f4xx_hal_flash_ex.o(i.FLASH_MassErase))

[Called By]

- >> HAL_FLASHEx_Erase

DMA_CalcBaseAndBitshift (Thumb, 38 bytes, Stack size 0 bytes, stm32f4xx_hal_dma.o(i.DMA_CalcBaseAndBitshift))

[Called By]

- >> HAL_DMA_Init
- >> HAL_DMA_DeInit

DMA_CheckFifoParam (Thumb, 120 bytes, Stack size 8 bytes, stm32f4xx_hal_dma.o(i.DMA_CheckFifoParam))

[Stack]

- Max Depth = 8
- Call Chain = DMA_CheckFifoParam

[Called By]

- >> HAL_DMA_Init

DMA_SetConfig (Thumb, 42 bytes, Stack size 12 bytes, stm32f4xx_hal_dma.o(i.DMA_SetConfig))

[Stack]

- Max Depth = 12
- Call Chain = DMA_SetConfig

[Called By]

- >> HAL_DMA_Start_IT

__NVIC_SetPriority (Thumb, 32 bytes, Stack size 0 bytes, stm32f4xx_hal_cortex.o(i.__NVIC_SetPriority))

[Called By]

- >> HAL_NVIC_SetPriority
- >> HAL_SYSTICK_Config

I2C_IsAcknowledgeFailed (Thumb, 46 bytes, Stack size 0 bytes, stm32f4xx_hal_i2c.o(i.I2C_IsAcknowledgeFailed))

[Called By]

- >> I2C_WaitOnTXEFlagUntilTimeout
- >> I2C_WaitOnBTFFlagUntilTimeout

I2C_RequestMemoryWrite (Thumb, 192 bytes, Stack size 32 bytes, stm32f4xx_hal_i2c.o(i.I2C_RequestMemoryWrite))

[Stack]

- Max Depth = 64
- Call Chain = I2C_RequestMemoryWrite ⇒ I2C_WaitOnMasterAddressFlagUntilTimeout

[Calls]

- >> I2C_WaitOnTXEFlagUntilTimeout
- >> I2C_WaitOnMasterAddressFlagUntilTimeout
- >> I2C_WaitOnFlagUntilTimeout

[Called By]

- >> HAL_I2C_Mem_Write

I2C_WaitOnBTFFlagUntilTimeout (Thumb, 78 bytes, Stack size 16 bytes, stm32f4xx_hal_i2c.o(i.I2C_WaitOnBTFFlagUntilTimeout))

[Stack]

- Max Depth = 16
- Call Chain = I2C_WaitOnBTFFlagUntilTimeout

[Calls]

- >> HAL_GetTick
- >> I2C_IsAcknowledgeFailed

[Called By]

- >> HAL_I2C_Mem_Write

I2C_WaitOnFlagUntilTimeout (Thumb, 122 bytes, Stack size 32 bytes, stm32f4xx_hal_i2c.o(i.I2C_WaitOnFlagUntilTimeout))

[Stack]

- Max Depth = 32
- Call Chain = I2C_WaitOnFlagUntilTimeout

[Calls]

- >> HAL_GetTick

[Called By]

- >> HAL_I2C_Mem_Write
- >> I2C_RequestMemoryWrite

I2C_WaitOnMasterAddressFlagUntilTimeout (Thumb, 168 bytes, Stack size 32 bytes, stm32f4xx_hal_i2c.o(i.I2C_WaitOnMasterAddressFlagUntilTimeout))

[Stack]

- Max Depth = 32
- Call Chain = I2C_WaitOnMasterAddressFlagUntilTimeout

[Calls]

- >> HAL_GetTick

[Called By]

- >> I2C_RequestMemoryWrite

I2C_WaitOnTXEFlagUntilTimeout (Thumb, 78 bytes, Stack size 16 bytes, stm32f4xx_hal_i2c.o(i.I2C_WaitOnTXEFlagUntilTimeout))

[Stack]

- Max Depth = 16
- Call Chain = I2C_WaitOnTXEFlagUntilTimeout

[Calls]

- >> HAL_GetTick
- >> I2C_IsAcknowledgeFailed

[Called By]

- >> HAL_I2C_Mem_Write
- >> I2C_RequestMemoryWrite

UART_DMAAbortOnError (Thumb, 16 bytes, Stack size 8 bytes, stm32f4xx_hal_uart.o(i.UART_DMAAbortOnError))

[Stack]

- Max Depth = 8
- Call Chain = UART_DMAAbortOnError

[Calls]

- >> HAL_UART_ErrorCallback

[Address Reference Count : 1]

- stm32f4xx_hal_uart.o(i.HAL_UART_IRQHandler)

UART_DMAError (Thumb, 74 bytes, Stack size 16 bytes, stm32f4xx_hal_uart.o(i.UART_DMAError))

[Stack]

- Max Depth = 16
- Call Chain = UART_DMAError

[Calls]

- >> HAL_UART_ErrorCallback
- >> UART_EndTxTransfer
- >> UART_EndRxTransfer

[Address Reference Count : 1]

- stm32f4xx_hal_uart.o(i.UART_Start_Receive_DMA)

UART_DMAReceiveCplt (Thumb, 130 bytes, Stack size 8 bytes, stm32f4xx_hal_uart.o(i.UART_DMAReceiveCplt))

[Stack]

- Max Depth = 8
- Call Chain = UART_DMAReceiveCplt

[Calls]

- >> HAL_UART_RxCpltCallback
- >> HAL_UARTEx_RxEventCallback

[Address Reference Count : 1]

- stm32f4xx_hal_uart.o(i.UART_Start_Receive_DMA)

UART_DMARxHalfCplt (Thumb, 26 bytes, Stack size 8 bytes, stm32f4xx_hal_uart.o(i.UART_DMARxHalfCplt))

[Stack]

- Max Depth = 8
- Call Chain = UART_DMARxHalfCplt

[Calls]

- >> HAL_UART_RxHalfCpltCallback
- >> HAL_UARTEx_RxEventCallback

[Address Reference Count : 1]

- stm32f4xx_hal_uart.o(i.UART_Start_Receive_DMA)

UART_EndRxTransfer (Thumb, 78 bytes, Stack size 0 bytes, stm32f4xx_hal_uart.o(i.UART_EndRxTransfer))

[Calls]

- >> UART_EndRxTransfer

[Called By]

- >> HAL_UART_IRQHandler
- >> UART_EndRxTransfer
- >> UART_DMAError

UART_EndTransmit_IT (Thumb, 26 bytes, Stack size 8 bytes, stm32f4xx_hal_uart.o(i.UART_EndTransmit_IT))

[Stack]

- Max Depth = 8
- Call Chain = UART_EndTransmit_IT

[Calls]

- >> HAL_UART_TxCpltCallback

[Called By]

- >> HAL_UART_IRQHandler

UART_EndTxTransfer (Thumb, 28 bytes, Stack size 0 bytes, stm32f4xx_hal_uart.o(i.UART_EndTxTransfer))

[Calls]

- >> UART_EndTxTransfer

[Called By]

- >> UART_EndTxTransfer
- >> UART_DMAError

UART_Receive_IT (Thumb, 198 bytes, Stack size 8 bytes, stm32f4xx_hal_uart.o(i.UART_Receive_IT))

[Stack]

- Max Depth = 8
- Call Chain = UART_Receive_IT

[Calls]

- >> HAL_UART_RxCpltCallback
- >> HAL_UARTEx_RxEventCallback

[Called By]

- >> HAL_UART_IRQHandler

UART_SetConfig (Thumb, 266 bytes, Stack size 24 bytes, stm32f4xx_hal_uart.o(i.UART_SetConfig))

[Stack]

- Max Depth = 64
- Call Chain = UART_SetConfig ⇒ __aeabi_uldivmod

[Calls]

- >> HAL_RCC_GetPCLK2Freq
- >> HAL_RCC_GetPCLK1Freq
- >> __aeabi_uldivmod

[Called By]

- >> HAL_UART_Init

UART_Transmit_IT (Thumb, 94 bytes, Stack size 0 bytes, stm32f4xx_hal_uart.o(i.UART_Transmit_IT))

[Called By]

- >> HAL_UART_IRQHandler

UART_WaitOnFlagUntilTimeout (Thumb, 116 bytes, Stack size 24 bytes, stm32f4xx_hal_uart.o(i.UART_WaitOnFlagUntilTimeout))

[Stack]

- Max Depth = 24
- Call Chain = UART_WaitOnFlagUntilTimeout

[Calls]

- >> HAL_GetTick

[Called By]

- >> HAL_UART_Transmit

_fp_digits (Thumb, 366 bytes, Stack size 64 bytes, printfa.o(i._fp_digits), UNUSED)

[Calls]

- >> __aeabi_dmul
- >> __aeabi_ddiv
- >> __aeabi_dadd
- >> __aeabi_d2ulz
- >> __aeabi_cdrcmple
- >> __aeabi_uldivmod

[Called By]

- >> _printf_core

_printf_core (Thumb, 1704 bytes, Stack size 136 bytes, printfa.o(i._printf_core), UNUSED)

[Calls]

- >> __aeabi_uidivmod
- >> _printf_pre_padding
- >> _printf_post_padding
- >> _fp_digits
- >> __aeabi_uldivmod

[Called By]

- >> __0vsnprintf

_printf_post_padding (Thumb, 36 bytes, Stack size 24 bytes, printfa.o(i._printf_post_padding), UNUSED)

[Called By]

- >> _printf_core

_printf_pre_padding (Thumb, 46 bytes, Stack size 24 bytes, printfa.o(i._printf_pre_padding), UNUSED)

[Called By]

- >> _printf_core

_snputc (Thumb, 22 bytes, Stack size 0 bytes, printfa.o(i._snputc))
[Address Reference Count : 1]

- printfa.o(i.__0vsnprintf)

### Undefined Global Symbols
