ChenFU-CN13/esp32-stm32-ab-ota/DOC/debugging/flash-fragmentation/ST-LINK Utility 固件碎片化对比图3.jpg

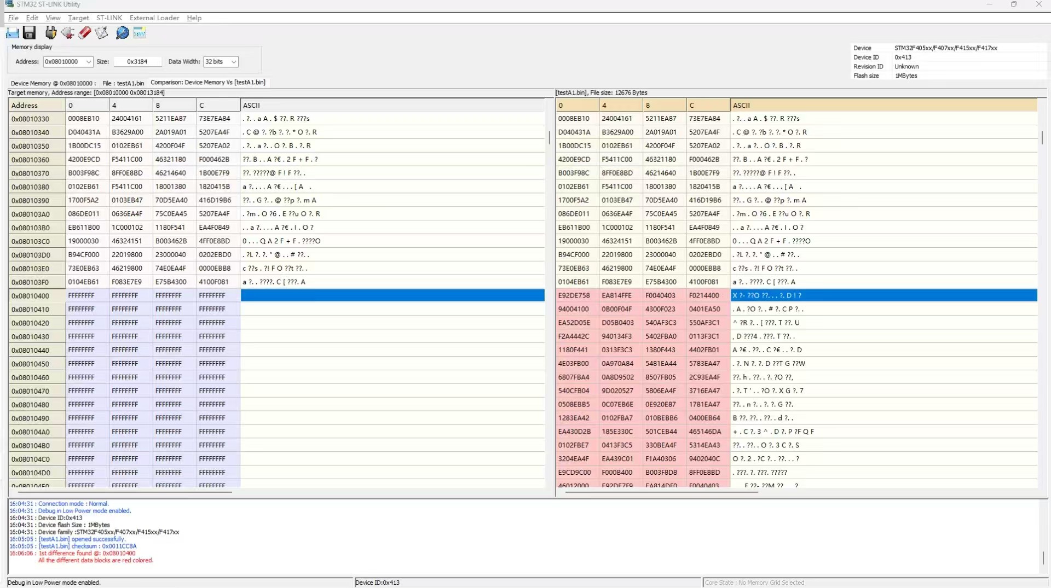
DOC/debugging/flash-fragmentation/ST-LINK Utility 固件碎片化对比图3.jpg
