ChenFU-CN13/esp32-stm32-ab-ota/STM32-OTA/A区智能哨兵环境监测系统/Core/Src/main.c

#include "main.h"
#include "cmsis_os.h"
#include "gpio.h"
#include "fan_pwm.h"

void SystemClock_Config(void);
void MX_FREERTOS_Init(void);
/* USER CODE BEGIN 0 */

/* 与Bootloader保持相同IWDG配置，避免跳转交接时出现超时窗口突变。 */
#define APP_IWDG_PRESCALER              4U      //PR  4 = 64 分频，超时约 5s，这里写4是对的，因为二进制是100，解码后就是64
#define APP_IWDG_RELOAD                 2499U   //重装载计数值
#define APP_IWDG_UPDATE_TIMEOUT         100U    //看门狗超时时间

//static IWDG_HandleTypeDef hiwdg_app;
//
//HAL_StatusTypeDef Watchdog_Init(void)
//{
//  	__HAL_DBGMCU_FREEZE_IWDG();             //调试保护：断点暂停CPU时IWDG也暂停，防止调试中被狗咬
//    hiwdg_app.Instance = IWDG;
//    hiwdg_app.Init.Prescaler = APP_IWDG_PRESCALER;
//    hiwdg_app.Init.Reload = APP_IWDG_RELOAD;
//    return HAL_IWDG_Init(&hiwdg_app);
//}

//上面是更简单的HAL库写法，下面是寄存器写法

/**
 * @brief 初始化正式APP独立看门狗。
 * @return HAL_OK-初始化成功；HAL_TIMEOUT-配置寄存器更新超时。
 * @note 若由Bootloader跳转而来，本函数会接管已运行的IWDG；冷启动时则主动启动IWDG。
 */
HAL_StatusTypeDef APP_Watchdog_Init(void)
{
	uint32_t start_tick;

	__HAL_DBGMCU_FREEZE_IWDG();             //调试保护：断点暂停CPU时IWDG也暂停，防止调试中被狗咬
	IWDG->KR = 0xCCCCU;                     //启动独立看门狗(硬件内部打开LSI时钟源)
	IWDG->KR = 0x5555U;                     //解锁PR/RL的写保护
	IWDG->PR = APP_IWDG_PRESCALER;          //设置分频系数
	IWDG->RLR = APP_IWDG_RELOAD;            //设置重装值

	start_tick = HAL_GetTick();
	while ((IWDG->SR & (IWDG_SR_PVU | IWDG_SR_RVU)) != 0U)  //这里是等待将预分频和重装值设置完成，PVU对应PR,RVU对应RLR
	{
		if ((HAL_GetTick() - start_tick) >= APP_IWDG_UPDATE_TIMEOUT)
		{
			return HAL_TIMEOUT;
		}
	}

	IWDG->KR = 0xAAAAU; //喂第一次狗，⑦喂第一口，计数器从2499开始重新递减
	return HAL_OK;
}





/**
 * @brief 刷新正式APP独立看门狗。
 * @return 无。
 * @note 写入重装载键不会在冷启动时自行启动IWDG，可安全用于Bootloader跳转早期接管。
 */
void APP_Watchdog_Refresh(void)
{
	IWDG->KR = 0xAAAAU;
  //(void)HAL_IWDG_Refresh(&hiwdg_app);   //HAL库写法
}

/* USER CODE END 0 */

/**
  * @brief  The application entry point.
  * @retval int
  */
int main(void)
{
/* USER CODE BEGIN 1 */

    /*
    * 正式OTA模式下，APP固定运行在0x08010000。
    * 必须在HAL_Init()前切换向量表，避免HAL初始化期间产生中断时跳回Bootloader向量表。
    */
    SCB->VTOR = FLASH_BASE | 0x00010000U;
    __DSB();
    __ISB();

    /*
    * Bootloader已经启动IWDG，跳转APP后IWDG不会停止。
    * APP必须尽早喂一次狗，防止后续时钟和外设初始化时间过长导致复位。
    */
    APP_Watchdog_Refresh();

/* USER CODE END 1 */

  /* MCU Configuration--------------------------------------------------------*/

  /* Reset of all peripherals, Initializes the Flash interface and the Systick. */
  HAL_Init();

  /* USER CODE BEGIN Init */

  /*
   * Bootloader跳转前关闭了全局中断，跳转到APP后该状态不会自动恢复。
   * 此时APP向量表和HAL基础环境已经就绪，可以重新开启全局中断。
   */
  __enable_irq();

  /* USER CODE END Init */

  /* Configure the system clock */
  SystemClock_Config();
	if (APP_Watchdog_Init() != HAL_OK)
	{
		Error_Handler();
	}

 
	MX_GPIO_Init();
	APP_Watchdog_Refresh();     //看门狗喂狗
	delay_init();
	usart_init(115200);//注意:这个是串口1
	USART2_DMA1_Init();
	USART2_Init(115200);
	USART3_Init(9600);
	APP_Watchdog_Refresh();     //看门狗喂狗
	sram_init();
	FAN_PWM_Init();
	APP_Watchdog_Refresh();     //看门狗喂狗

  
	printf("============================= \r\n");
	printf("enter A code is successfully! \r\n");
  //printf("调试:该固件版本为v2.0.0! \r\n");
  printf("调试:该固件版本为v2.0.2! \r\n");
	printf("[IWDG] APP已接管，超时限制约5000 ms\r\n");
	printf("============================= \r\n");

	
  /* Init scheduler */
  osKernelInitialize();  /* Call init function for freertos objects (in freertos.c) */
	APP_Watchdog_Refresh();   //看门狗喂狗
  MX_FREERTOS_Init();
	APP_Watchdog_Refresh();   //看门狗喂狗
	
  /* Start scheduler */
  osKernelStart();    //开启调度器
  /* We should never get here as control is now taken by the scheduler */
  /* Infinite loop */
  /* USER CODE BEGIN WHILE */
  

  while (1)
  {
    /* USER CODE END WHILE */


    /* USER CODE BEGIN 3 */
  }
  /* USER CODE END 3 */
}

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
/**
 * @brief  定时器回调函数   
 * @param   对象句柄      
 * @retval   无     
 */
void HAL_TIM_PeriodElapsedCallback(TIM_HandleTypeDef *htim)
{
    /*
     * 工程将 TIM7 配置为 HAL 的 1 ms 时基。
     * HAL_GetTick()、UART ACK 超时和 HAL 内部超时都依赖此处递增 uwTick。
     * FreeRTOS 使用 SysTick 维护任务节拍，因此不能依赖 SysTick 来驱动 HAL 时基。
     */
    if (htim->Instance == TIM7)
    {
        HAL_IncTick();
    }
    else if (htim->Instance == TIM6)
    {
//        lv_tick_inc(1);                 
    }
}




/**
  * @brief  This function is executed in case of error occurrence.
  * @retval None
  */
void Error_Handler(void)
{
  /* USER CODE BEGIN Error_Handler_Debug */
  /* User can add his own implementation to report the HAL error return state */
  __disable_irq();
  while (1)
  {
		printf("Init_fail");
  }
  /* USER CODE END Error_Handler_Debug */
}

#ifdef  USE_FULL_ASSERT
/**
  * @brief  Reports the name of the source file and the source line number
  *         where the assert_param error has occurred.
  * @param  file: pointer to the source file name
  * @param  line: assert_param error line source number
  * @retval None
  */
void assert_failed(uint8_t *file, uint32_t line)
{
  /* USER CODE BEGIN 6 */
  /* User can add his own implementation to report the file name and line number,
     ex: printf("Wrong parameters value: file %s on line %d\r\n", file, line) */
  /* USER CODE END 6 */
}
#endif /* USE_FULL_ASSERT */
