ChenFU-CN13/esp32-stm32-ab-ota/STM32-OTA/A区智能哨兵环境监测系统/LVGL_RTOS_DOME5.ioc

Mcu.UserName=STM32F407ZGTx
PA13.Signal=SYS_JTMS-SWDIO
PA14.Signal=SYS_JTCK-SWCLK
PC14-OSC32_IN.Signal=RCC_OSC32_IN
PC15-OSC32_OUT.Signal=RCC_OSC32_OUT
PH0-OSC_IN.Signal=RCC_OSC_IN
PH1-OSC_OUT.Signal=RCC_OSC_OUT
