ChenFU-CN13/esp32-stm32-ab-ota/ESP32S3-OTA/main/iot/wifi_manager.c

#include "wifi_manager.h"
#include <stdio.h>
#include "esp_log.h"
#include <string.h>
#include "esp_netif.h"
#include "esp_wifi.h"
#include "esp_event.h"

#define TAG     "wifi_manager"

//重连次数
#define MAX_CONNECT_RETRY   6
static int sta_connect_count = 0;

//回调函数
static p_wifi_state_callback    wifi_state_cb = NULL;

//当前sta连接状态
static bool is_sta_connected = false;

/** 事件回调函数
 * @param arg   用户传递的参数
 * @param event_base    事件类别
 * @param event_id      事件ID
 * @param event_data    事件携带的数据
 * @return 无
*/
static void event_handler(void* arg, esp_event_base_t event_base,int32_t event_id, void* event_data)
{   
    if(event_base == WIFI_EVENT)
    {
        switch (event_id)
        {
        case WIFI_EVENT_STA_START:      //WIFI以STA模式启动后触发此事件
        {
            wifi_mode_t mode;
            esp_wifi_get_mode(&mode);
            if(mode == WIFI_MODE_STA)
                esp_wifi_connect();         //启动WIFI连接
            break;
        }
        case WIFI_EVENT_STA_CONNECTED:  //WIFI连上路由器后，触发此事件
            ESP_LOGI(TAG, "Connected to STA");
            break;
        case WIFI_EVENT_STA_DISCONNECTED:   //WIFI从路由器断开连接后触发此事件
            if(is_sta_connected)
            {
                if(wifi_state_cb)
                    wifi_state_cb(WIFI_STATE_DISCONNECTED);
                is_sta_connected = false;
            }
            if(sta_connect_count < MAX_CONNECT_RETRY)
            {
                wifi_mode_t mode;
                esp_wifi_get_mode(&mode);
                if(mode == WIFI_MODE_STA)
                    esp_wifi_connect();             //继续重连
                sta_connect_count++;
            }
            ESP_LOGI(TAG,"connect to the AP fail,retry now");
            break;
        default:
            break;
        }
    }
    if(event_base == IP_EVENT)                  //IP相关事件
    {
        switch(event_id)
        {
            case IP_EVENT_STA_GOT_IP:           //只有获取到路由器分配的IP，才认为是连上了路由器
                ESP_LOGI(TAG,"Get ip address");
                /* 一次成功连接即结束本轮重试计数，避免累计断线6次后永久停止重连。 */
                sta_connect_count = 0;
                is_sta_connected = true;
                if(wifi_state_cb)
                    wifi_state_cb(WIFI_STATE_CONNECTED);
                break;
            default:break;
        }
    }
}

/** 初始化wifi，默认进入STA模式
 * @param f   状态回调函数
 * @return 无 
*/
void wifi_manager_init(p_wifi_state_callback f)
{
    ESP_ERROR_CHECK(esp_netif_init());  //用于初始化tcpip协议栈
    ESP_ERROR_CHECK(esp_event_loop_create_default());       //创建一个默认系统事件调度循环，之后可以注册回调函数来处理系统的一些事件
    esp_netif_create_default_wifi_sta();    //使用默认配置创建STA对象
    //初始化WIFI
    wifi_init_config_t cfg = WIFI_INIT_CONFIG_DEFAULT();
    ESP_ERROR_CHECK(esp_wifi_init(&cfg));
    
    //注册事件
    ESP_ERROR_CHECK(esp_event_handler_register(WIFI_EVENT,ESP_EVENT_ANY_ID,&event_handler,NULL));
    ESP_ERROR_CHECK(esp_event_handler_register(IP_EVENT,IP_EVENT_STA_GOT_IP,&event_handler,NULL));

    wifi_state_cb = f;//
    //启动WIFI
    ESP_ERROR_CHECK(esp_wifi_set_mode(WIFI_MODE_STA) );         //设置工作模式为STA
    ESP_ERROR_CHECK(esp_wifi_start() );                         //启动WIFI
    
    ESP_LOGI(TAG, "wifi_init finished.");
}

/** 连接wifi
 * @param ssid
 * @param password
 * @return 成功/失败
*/
esp_err_t wifi_manager_connect(const char* ssid,const char* password)
{
    sta_connect_count = 0;
    wifi_config_t wifi_config = 
    {
        .sta = 
        {
	        .threshold.authmode = WIFI_AUTH_WPA2_PSK,   //加密方式
        },
    };
    snprintf((char*)wifi_config.sta.ssid,31,"%s",ssid);
    snprintf((char*)wifi_config.sta.password,63,"%s",password);
    ESP_ERROR_CHECK(esp_wifi_disconnect());
    wifi_mode_t mode;
    esp_wifi_get_mode(&mode);
    if(mode != WIFI_MODE_STA)
    {
        ESP_ERROR_CHECK(esp_wifi_stop());
        ESP_ERROR_CHECK(esp_wifi_set_mode(WIFI_MODE_STA));
        ESP_ERROR_CHECK(esp_wifi_set_config(WIFI_IF_STA, &wifi_config));
        esp_wifi_start();
    }
    else
    {
        ESP_ERROR_CHECK(esp_wifi_set_config(WIFI_IF_STA, &wifi_config));
        esp_wifi_connect();
    }
    return ESP_OK;
}
