ChenFU-CN13/esp32-stm32-ab-ota/ESP32S3-OTA/main/credentials.example.h

#ifndef CREDENTIALS_EXAMPLE_H
#define CREDENTIALS_EXAMPLE_H

/*
 * 复制本文件为 credentials.h，再填写本机Wi-Fi和OneNET设备信息。
 * credentials.h已加入.gitignore，禁止把真实口令和访问密钥提交到Git。
 */
#define DEFAULT_SSID         "YOUR_WIFI_SSID"
#define DEFAULT_PASSWORD     "YOUR_WIFI_PASSWORD"

#define ONENET_PRODUCT_ID    "YOUR_PRODUCT_ID"
#define ONENET_ACCESS_KEY    "YOUR_ACCESS_KEY"
#define ONENET_DEVICE_NAME   "YOUR_DEVICE_NAME"

#endif
