ChenFU-CN13/esp32-stm32-ab-ota/STM32-OTA/testB3/Drivers/bootloader_drivers/inc/AT24C02.h

#ifndef AT24C02_H
#define AT24C02_H

#include "main.h"
#include "i2c.h"

 
#define I2C_HANDLE		hi2c1
//设备ID地址
#define DEV_ADDR_24CXX	0x00A0
 
#define PAGE_SIZE_24CXX	0x0008
#define MEM_SIZE_24CXX	(uint16_t)256
 
HAL_StatusTypeDef EP24C_IsDeviceReady(void);
HAL_StatusTypeDef EP24C_WriteOneByte(uint16_t memAddress, uint8_t byteData);
HAL_StatusTypeDef EP24C_ReadOneByte(uint16_t memAddress, uint8_t *byteData);
HAL_StatusTypeDef EP24C_ReadBytes(uint16_t memAddress, 
								uint8_t *pBuffer, 
								uint16_t bufferLen,
								uint16_t buffer_Len_Max);
HAL_StatusTypeDef EP24C_WriteInOnePage(uint16_t memAddress, uint8_t *pBuffer, uint16_t bufferLen);
HAL_StatusTypeDef EP24C_WriteLongData(uint16_t memAddress, uint8_t *pBuffer, uint16_t bufferLen);
/**
 * @brief   安全写入任意长度数据，自动按AT24C02页边界拆分
 * @note    不允许越过256B存储空间；每次页写完成后等待内部写周期。
 */
HAL_StatusTypeDef EP24C_WriteBytes(uint16_t memAddress, const uint8_t *pBuffer, uint16_t bufferLen);
 
void test_AT24C02(void);




#endif
