ChenFU-CN13/esp32-stm32-ab-ota/(commit log)

2026-08-16 chore: import existing ESP32 STM32 OTA project
2026-08-21 feat(ota): 实现固件端到端CRC32校验，修复帧CRC语义错位bug
    问题背景：
    信息帧中的帧CRC32被STM32端误当固件整体CRC使用，
    若直接启用OTA_VerifyFirmwareCRC()校验必然失败。
    ESP32端从未计算过固件整体CRC32。
    修复内容（信息帧 21→25 字节）：
    ESP32端 (myuart.c/onenet_ota.c):
    - 下载固件到SPIFFS时流式累加CRC32（与MD5同流程）
    - 新增 crc32_stream_init/update/final 流式API
    - send_firmware_info 加 fw_crc 参数，真固件CRC随信息帧下发
    - calculate_crc32 统一改用流式API（逐帧与整体同算法）
    STM32端 (TaskTest.c/h):
    - OTA_INFO_FRAME_LEN 21→25，解析偏移调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
2026-08-21 docs: 添加项目 README 文档
2026-08-21 feat:OTA增加NACK错误应答、ABORT终止传输，ESP与STM32协议对齐
2026-08-22 1.移除旧的myuart.c并进行功能解耦 分为现有四个独立模块 2.新增文件crc32.c/.h uart_driver.c/.h ota_proto.c/.h ota_session.c/.h 3.myuart.h 变成 20 行纯聚合头 4.关键改动：（1）uart_queue、g_ota_uart_busy 从同文件可见→ uart_driver.h 里 extern（会话层 clean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
2026-08-23 重构testB的OTA程序，原本TaskTest.c混合了AB区跳转，升级状态机，CRC32校验，FLASH檫除写入，协议帧构造与解析等职责。现在仅保留任务入口函数 Task_Main / Task_While。 * 其余 Bootloader 核心逻辑已拆分为独立模块：
2026-08-23 修改过了.gitignore文件，添加新的禁止添加文件名类型
2026-08-24 feat(ota): 实现双端回滚恢复、版本闭环与常驻升级管理
    STM32 Bootloader新增W25Q128单备份回滚、升级状态持久化和IWDG异常恢复。
    STM32 APP新增USART2可靠通信、OTA通知应答、版本上报和主动版本查询响应。
    ESP32-S3新增常驻OTA Manager、MQTT多入口触发、当前版本同步和双核任务调度。
    修复UART拆包粘包、SPIFFS重复挂载、MQTT重复任务及双端独立重启后的版本同步问题。
2026-08-24 chore(git): 停止跟踪Keil编译生成文件
2026-08-27 feat(lvgl): 完成智能环境监测UI大更新
    重构首页与设置页UI、字体及图标资源，完成正式APP集成。
    正式APP目录更名为智能哨兵环境监测系统，并保留NoBoot调试配置。
2026-08-29 feat(app): 完成智能哨兵环境监测扩展与实机联调
2026-10-17 feat: 发布 v2.0.0 SHT30 正式版并回归 OTA
2026-10-18 feat: 整理并发布双 MCU OTA 项目
    - 清理历史测试与备份工程
    - 重构 README 与公开文档结构
    - 补充 OTA 故障复盘、代码对比和验证边界
    - 保留 UART 并发修复及当前版本配置
2026-10-18 docs: 移除内部项目进度记录
    停止跟踪项目进度与验证记录，并清理公开文档导航；本地文件通过 .gitignore 保留。
2026-10-22 docs: 新增双端 OTA 引脚协议与运行逻辑说明
2026-10-28 docs: 补充 OTA 与串口通信代码中文注释
2026-10-29 feat: 2.0.5 改用累计式串口环形缓冲区
    STM32 APP 和 Bootloader 使用累计读写计数，通过掩码访问软件环。
    APP 保留单字节拒收与溢出恢复接口；Bootloader 空间不足时整批拒收，新增拒收字节计数，避免覆盖未读数据。
    完善 Bootloader 接收初始化，并修复独立回显测试中 DMA 引用局部数组的生命周期问题。
    同步用户关闭 ESP32 OTA busy 日志及 APP 2.0.5 启动调试文字的修改。
    补充正常升级历史日志、更新说明与 Python 协议测试接入计划。
    区分历史 2.0.3 日志、用户提供的 2.0.4 成功证据与本次 2.0.5 调试标识。
    记录 busy 分支关闭日志后也会静默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
2026-10-31 feat: 完善串口组帧并新增 Python OTA 测试
    在累计式软件环上增加按协议长度提帧，保留半帧和后续帧，统一握手与接收入口，修正短数据帧分流和阶段超时处理。
    新增 Python OTA 采集、拆帧/粘帧注入、整体 CRC 故障、主动 ABORT、数据超时及人工断电入口；收尾与恢复 CRC 分别记录。
    更新 README、运行说明与公开验证摘要，记录异常恢复后再次升级、实际断电恢复及 ESP32-S3 升级到 2.0.8 的实机结果。
    验证：23 个 Python 离线测试通过，15 个脚本语法及 46 个文档链接核对通过；发布操作不连接真实串口，不重复编译或烧录。
2026-11-01 docs: 补充 OTA 命令宏与 Bootloader 状态机说明
